m-lego/m65/README.md

the lego keyboard
=================

more info and notes [here](https://mlego.elena.re/m65/) and [here](https://mlego.elena.re/)
