m-lego/m65/notes/tipro8x4.md

## tipro 8x4

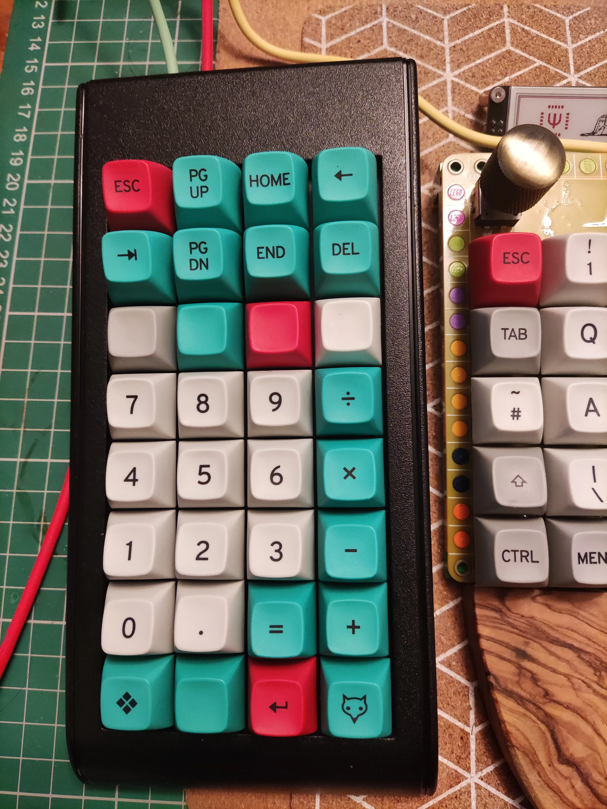
[picture p165: notes/pics/tipro/tipro8x4.webp]
tipro 32 8x4
  

### introduction

### wiring

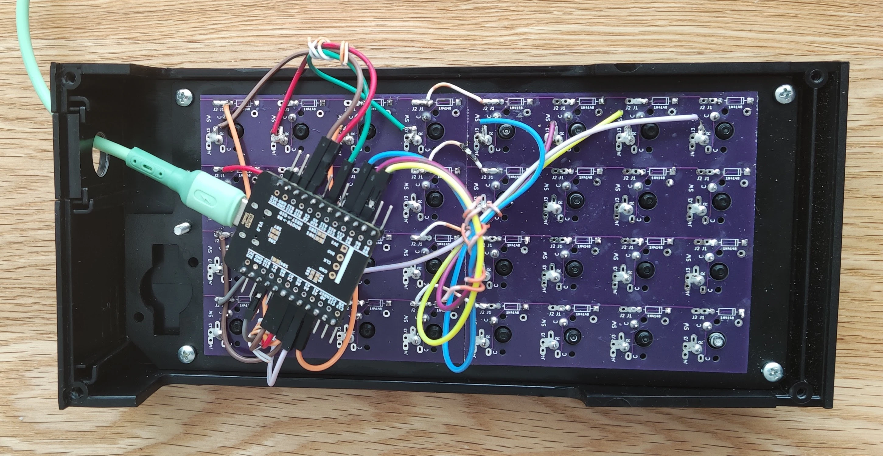
[picture p166: notes/pics/tipro/tipro8x4-pcb.webp]
tipro 32 8x16
 

### mcu

the mcu is stm32g431 from [weact](https://www.aliexpress.com/item/1005005303669884.html)

### firmware

  ready made firmware can be downloaded from [github actiona](https://github.com/alinelena/qmk_firmware/actions/workflows/build.yml)
naaviate to **build firmware for mlego** and click onthe latest successful workflow and download **tipro32_default** from the list.

### pictures

original

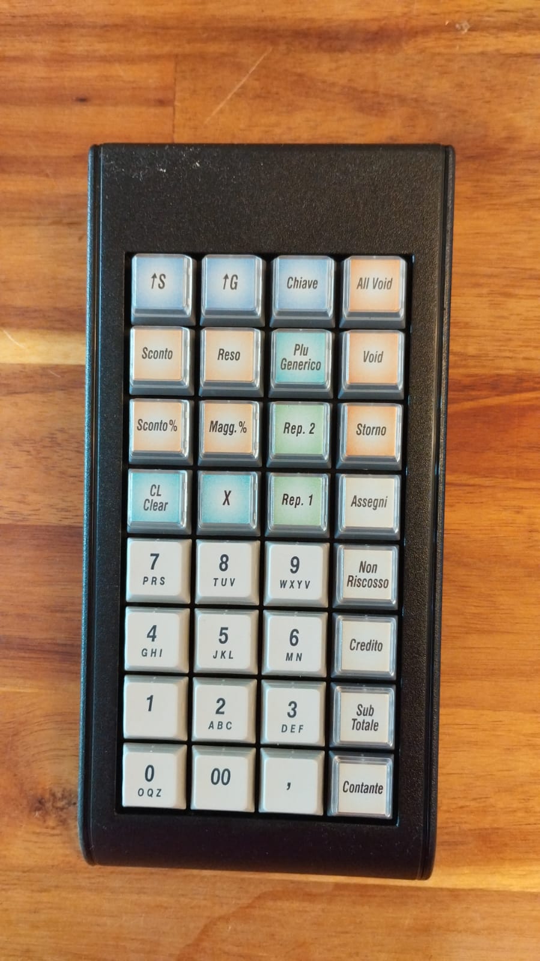
[picture p167: notes/pics/tipro/tipro8x4-orig.jpeg]
tipro 32 8x16
