m-lego/m65/notes/tiproansi-ortho.md

## tipro ansi ortho

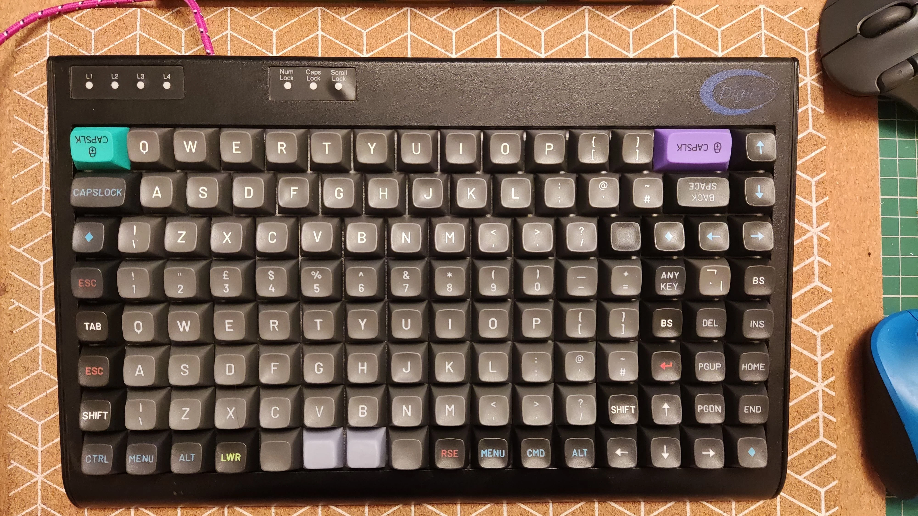
[picture p168: notes/pics/tipro/tiproansi-ortho.webp]
tipro 128 8x16
  

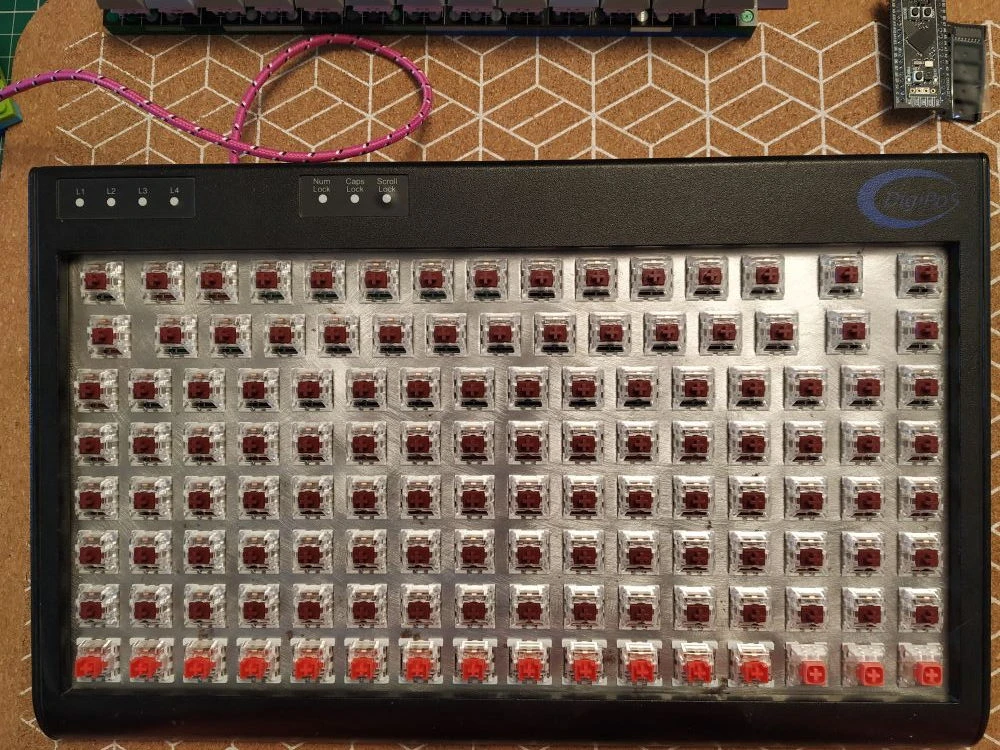
[picture p169: notes/pics/tipro/tipro-ansiortho-nokeys.webp]
tipro 128 8x16
  

### introduction

this is an ansi ortho combination from tipro that I have converted to qmk using same technique as [here](https://mlego.elena.space/tipro8x16/)

uses the same mcu.

### wiring

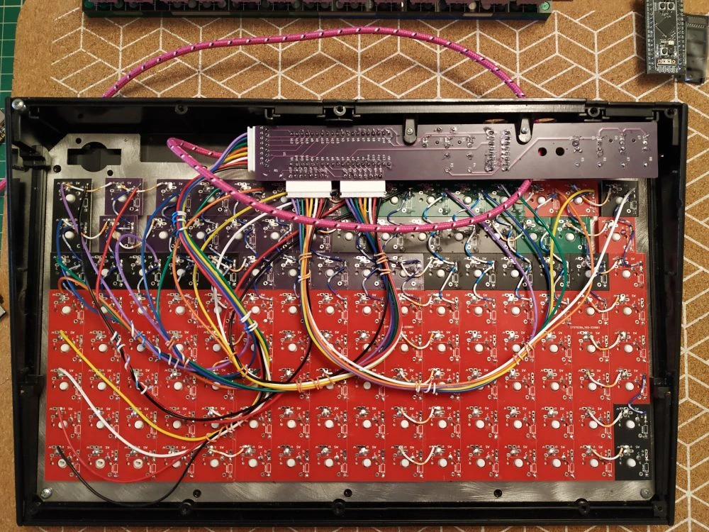
[picture p170: notes/pics/tipro/tiproansi-ortho-back.webp]
tipro 128 8x16
 

  full kicad project for the pcb in [here](https://gitlab.com/m-lego/hand8x16/)

### firmware

  ready made firmware can be downloaded

  + [tipro_rev1_default_ansiortho.uf2](https://gitlab.com/m-lego/hand8x16/-/blob/develop/firmware/tipro_rev1_default_ansiortho.uf2)

  build your own

   ```bash
      git clone --recurse-submodules -b mlego https://github.com/alinelena/qmk_firmware.git qmk-alin
      cd qmk-alin
      qmk compile -kb tipro/rev1 -km default_ansiortho

   ```

### pins

the same as 8x16

### photos

original

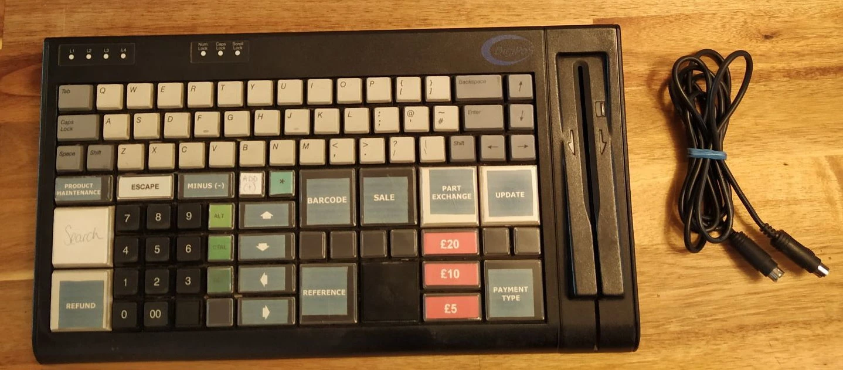
[picture p171: notes/pics/tipro/tipro-ansi-ortho-orig.webp]
tipro 128 8x16
