m-lego/m65/notes/tiproortho-ansi.md

## tipro ortho ansi

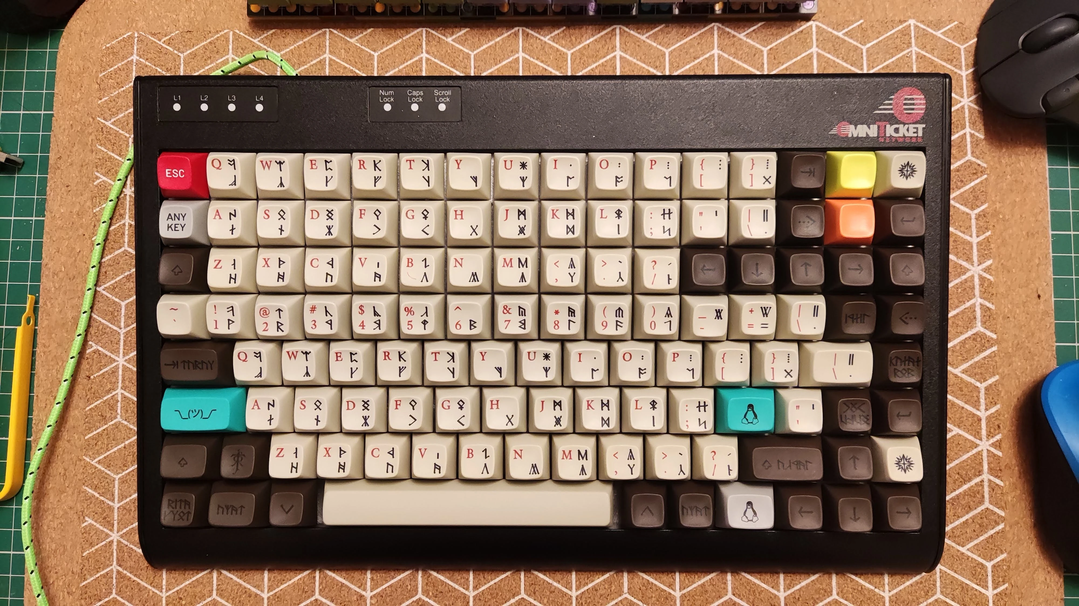
[picture p172: notes/pics/tipro/tiproortho-ansi.webp]
tipro 128 8x16
  

### introduction

this is an ortho ansi combination from tipro that I have converted to use qmk using same pcb as [here](https://mlego.elena.space/tipro8x16/)

this is in working, page updated once finished.

### wiring

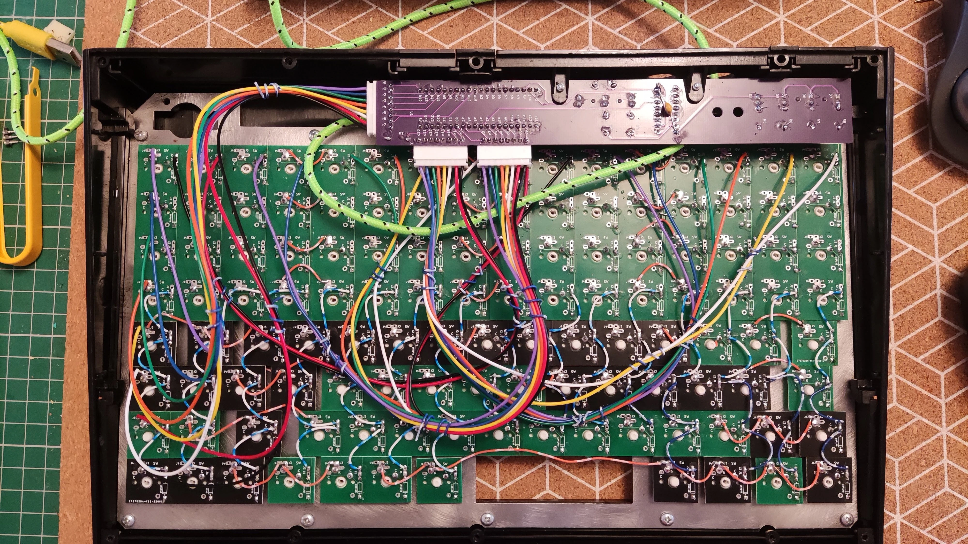
[picture p173: notes/pics/tipro/tipro_orthoansi_bottom.webp]
m128 ortho ansi


### firmware

### other pictures

original

m128 ortho ansi

cleaned

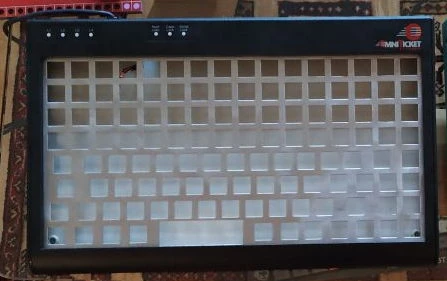
[picture p174: notes/pics/tipro/tipro-ortho-ansi-v1.webp]
m128 ortho ansi


switches

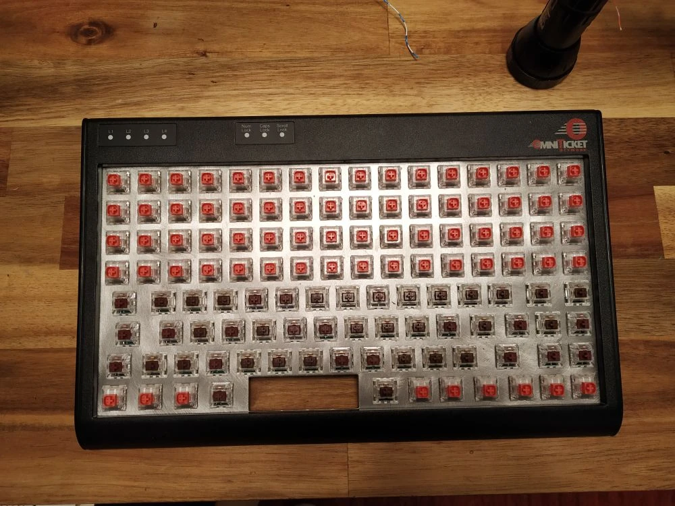
[picture p175: notes/pics/tipro/tipro-ortho-ansi-v2.webp]
m120 ortho ansi
