m-lego/m65/notes/converted/index.md

# converted

a set of converted pos terminals. All these are tipro they are mechanical so I just adapted them.
Majority came from ebay relatively cheap.

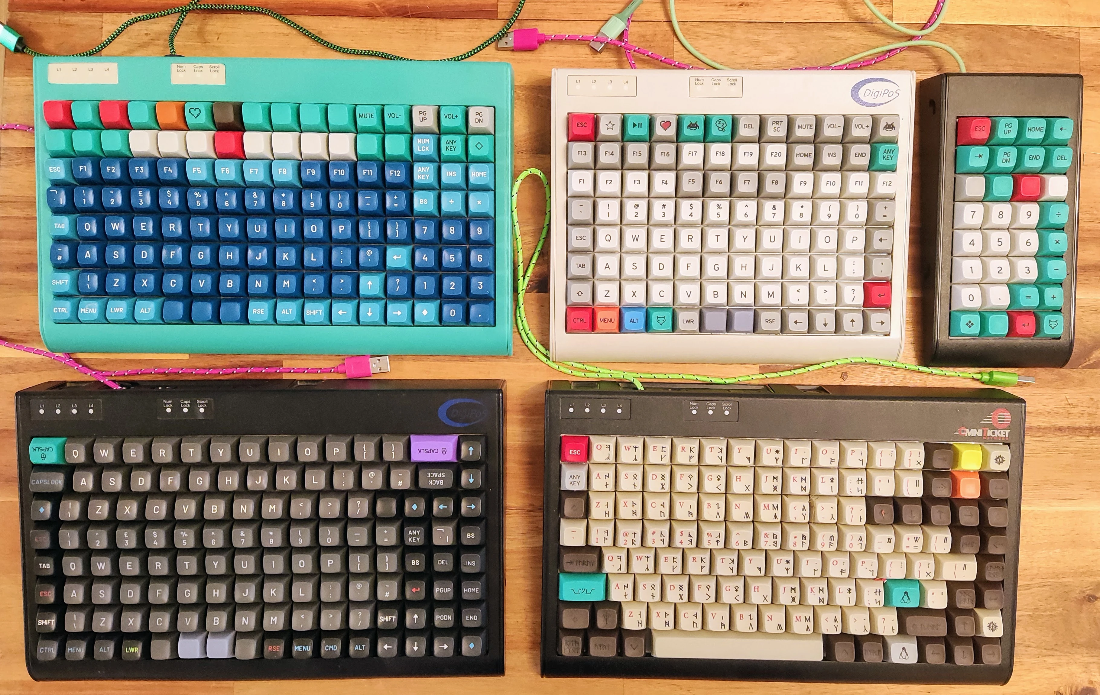
[picture p180: notes/pics/converted-all.webp]
converted pos
