m-lego/m65/notes/keyboards/index.md

# Keyboards

a set of keyboard that I have designed and built for fun and to eperiment with qmk or electronics.

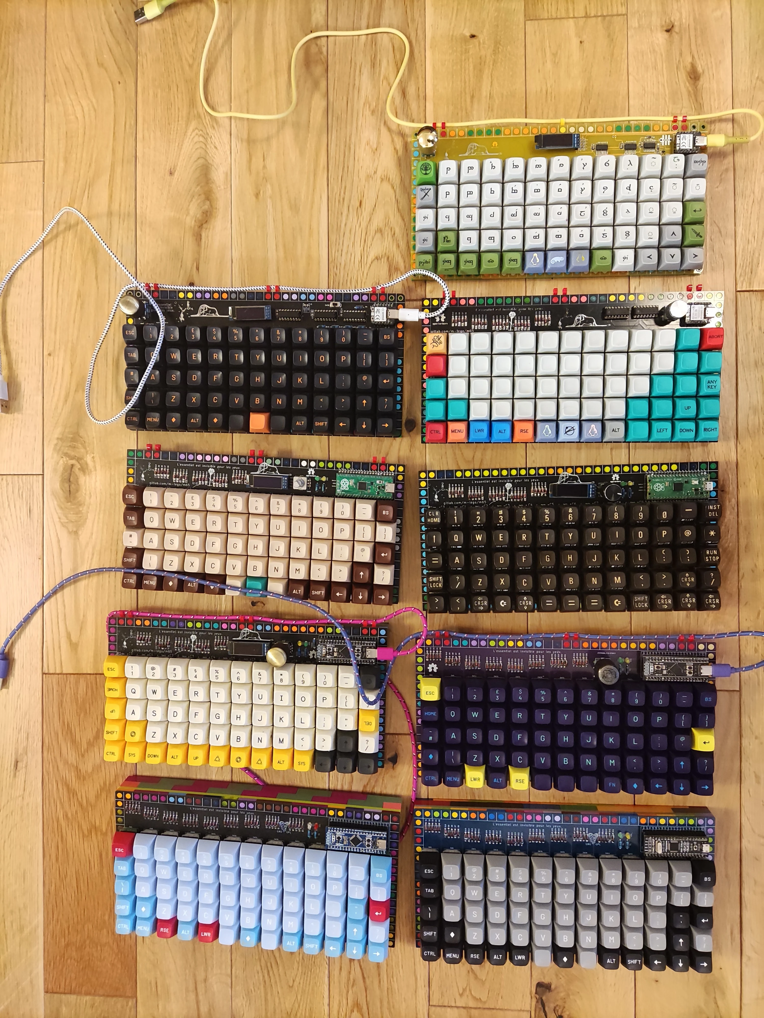
[picture p181: notes/pics/m65-rev1-10.webp]
the family
