m-lego/m65/notes/pics/hand/hand-5x5-3d.webp

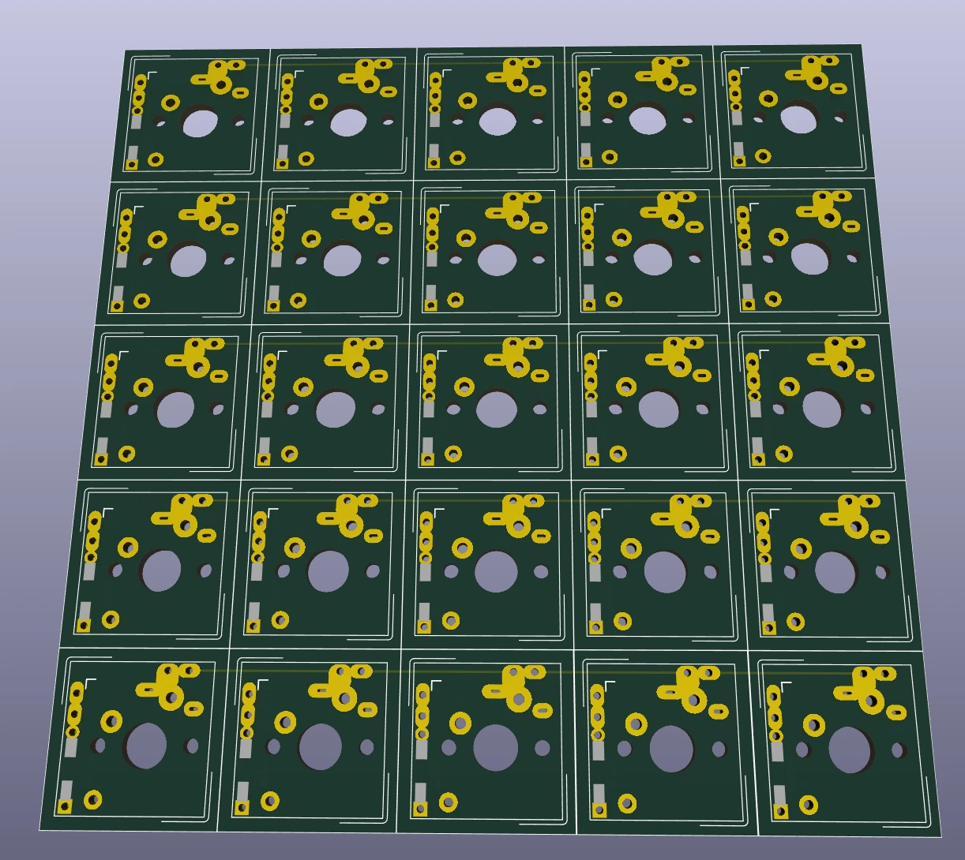
notes/pics/hand/hand-5x5-3d.webp
