m-lego/m65/notes/pics/hand/m4-matrix-pcb.webp

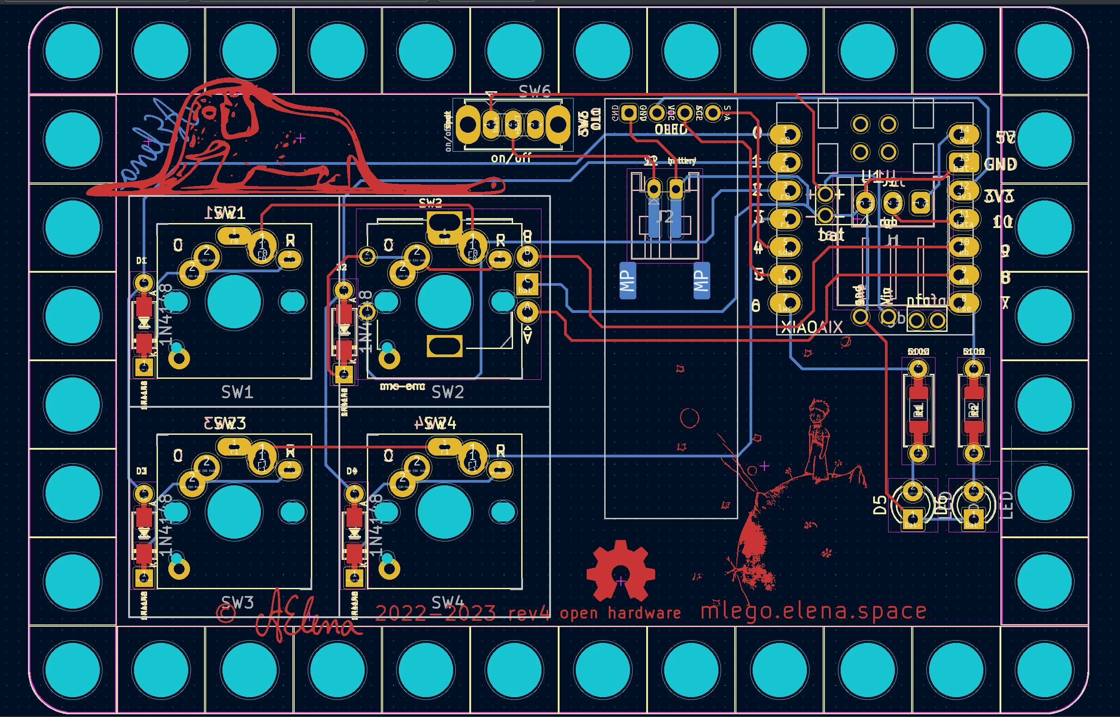
notes/pics/hand/m4-matrix-pcb.webp
