m-lego/m65/notes/pics/m4/m2x2-rev4-3d.webp

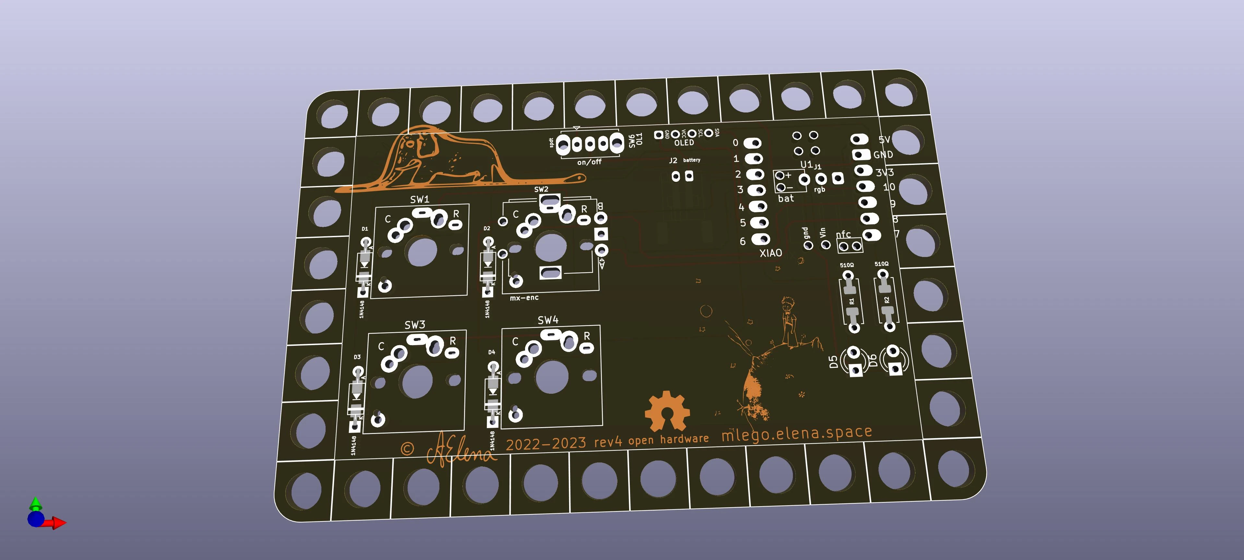
notes/pics/m4/m2x2-rev4-3d.webp
