m-lego/m65/notes/pics/m20/m20_v3.webp

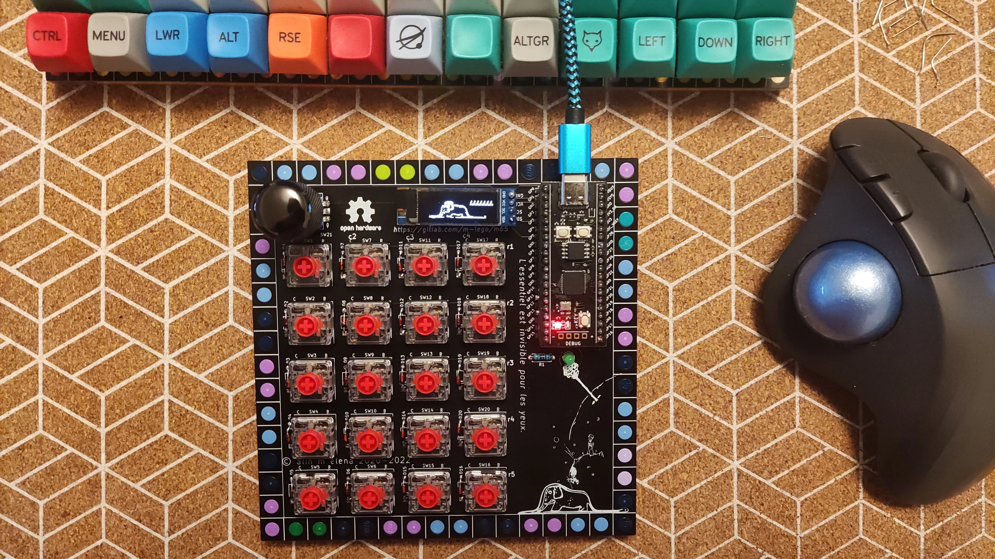
notes/pics/m20/m20_v3.webp
