m-lego/m65/notes/pics/m65-rev7-xiao-ble.webp

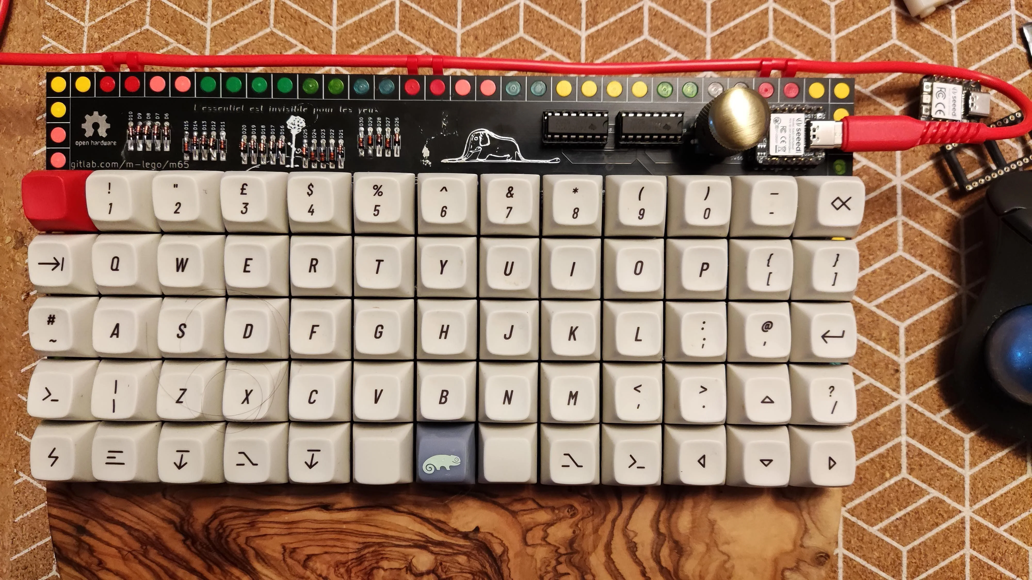
notes/pics/m65-rev7-xiao-ble.webp
