m-lego/m65/notes/pics/m65-rev9-render.webp

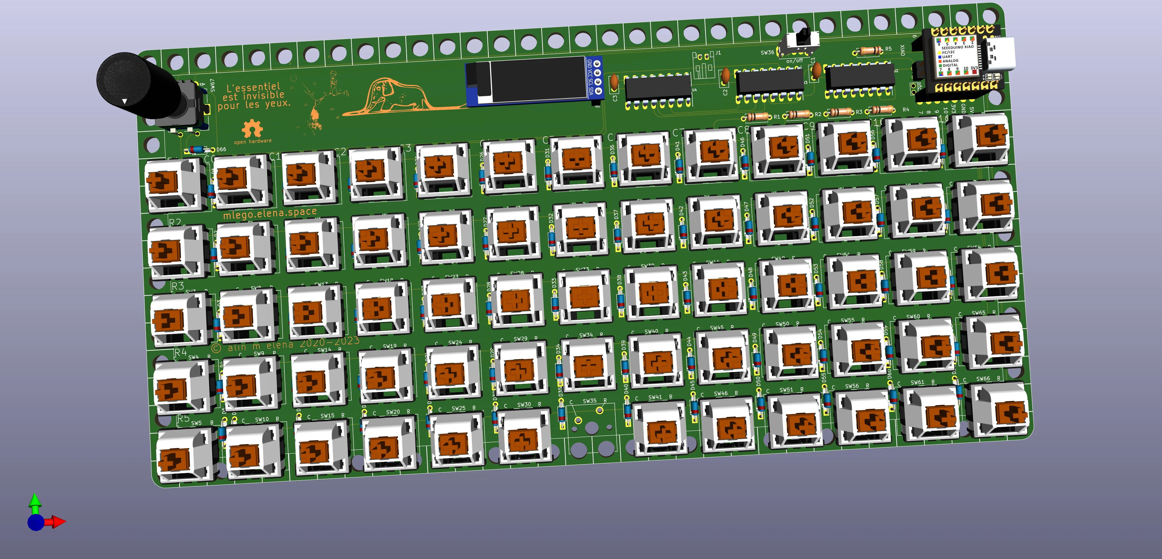
notes/pics/m65-rev9-render.webp
