m-lego/m65/notes/pics/mlego.webp

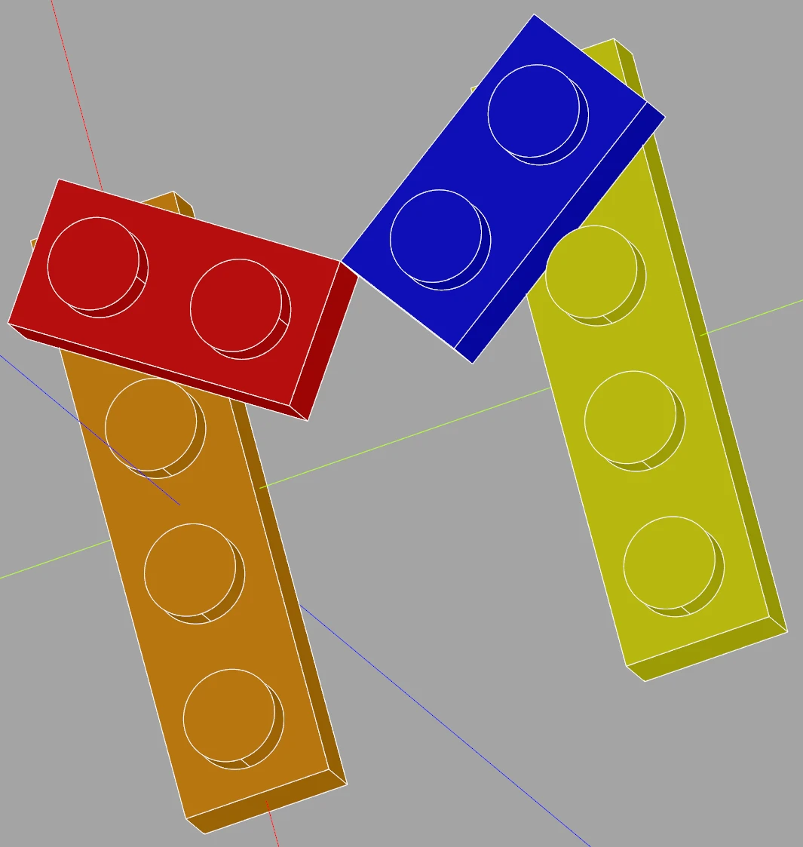
notes/pics/mlego.webp
