m-lego/m65/pics/m65-layout.png

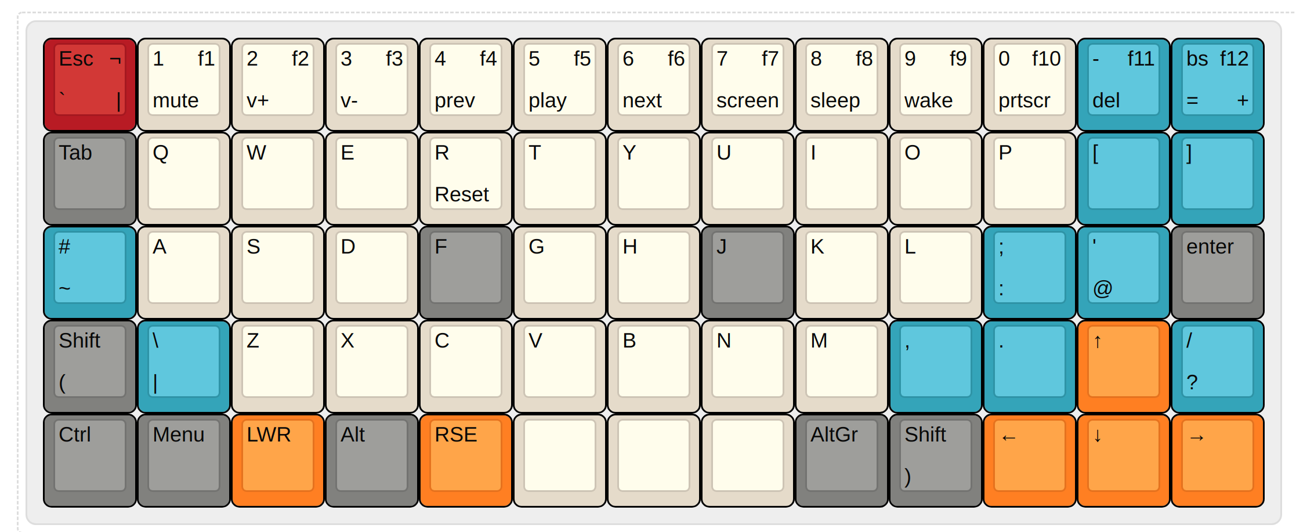
pics/m65-layout.png
