m-lego/m65/pics/m65-rev4-pcb.png

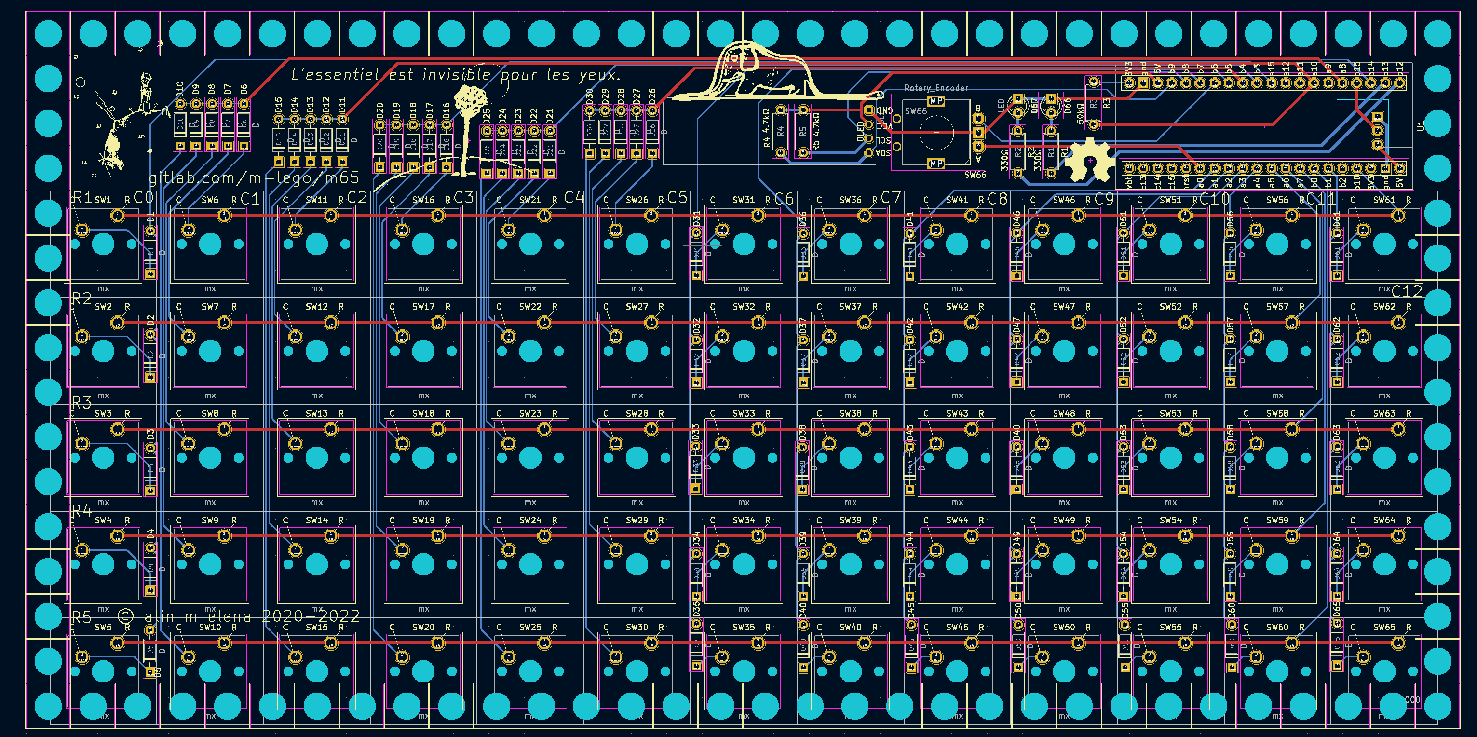
pics/m65-rev4-pcb.png
