m-lego/m65/pics/m65-rev4.jpg

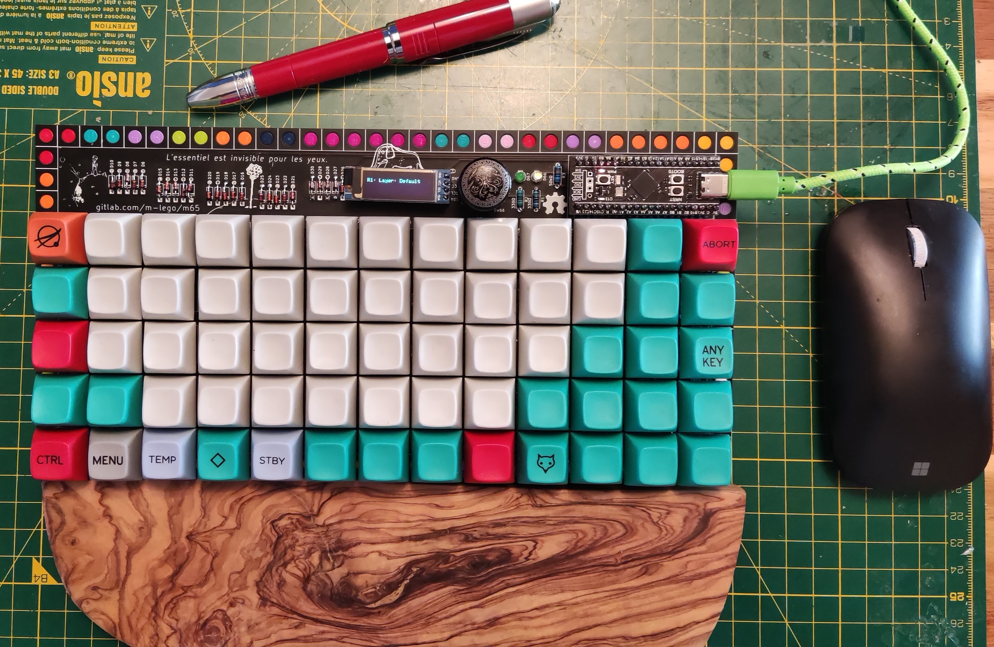
pics/m65-rev4.jpg
