m-lego/m65/pics/m65-tty.png

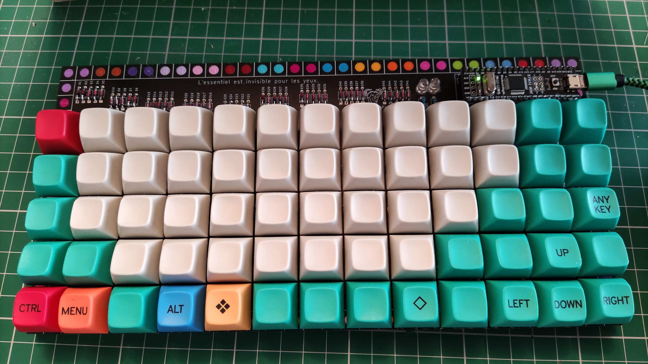
pics/m65-tty.png
