m-lego/m65/pics/m65-v4.jpg

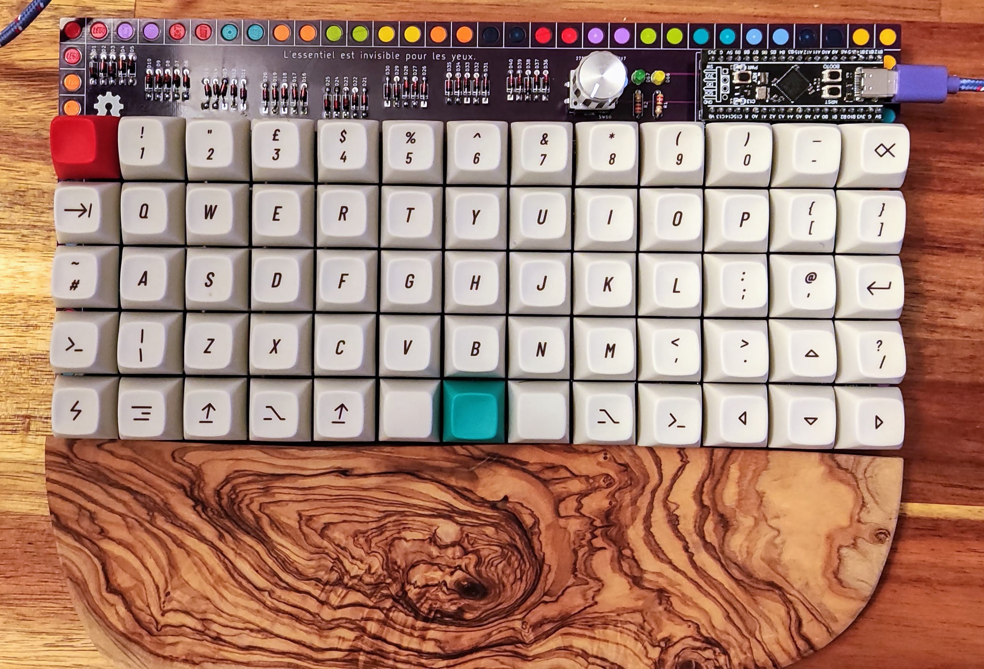
pics/m65-v4.jpg
