m-lego/m65/pics/socket_4.jpg

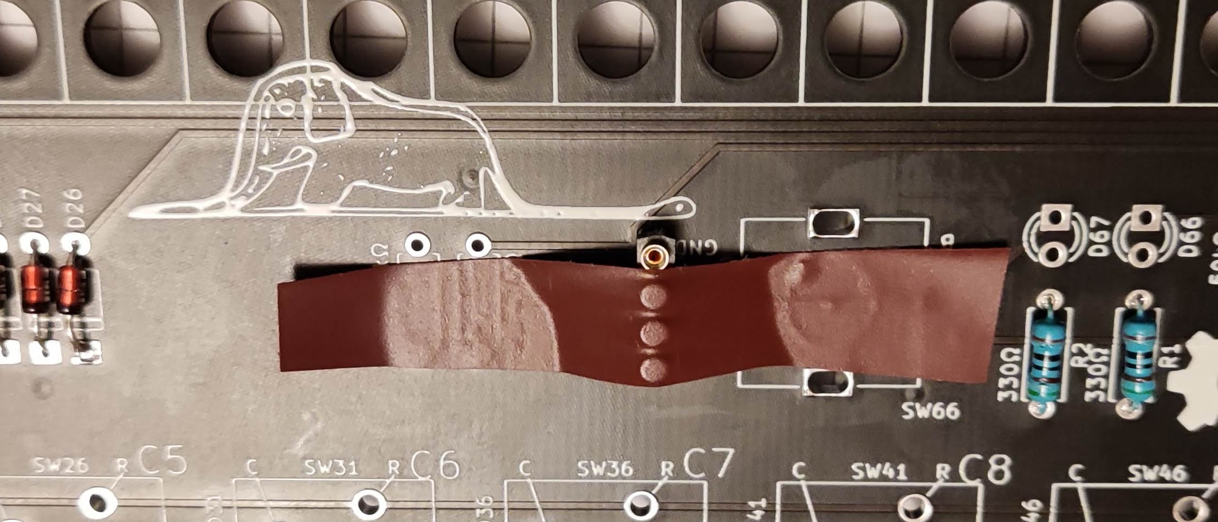
pics/socket_4.jpg
