m-lego/m65/notes/assembly.md

## assembly guide

### before you start

!!! warning

    this is a rushed assembly guide... assumes you know how to solder and you already read the bom section and have all of them plus the pcb.
    while the complexity of the job is low, it may take over 2h of your time to put it together.

!!! info

    familiarise yourself with the pcb

front of the pcb

pcb

back of the pcb

pcb

front of the PCB is the one with the artwork on.
you can ignore R4 and R5 since they are for use only in advaced cases when special oleds are used.
if you go for the full build all other footprints will be populated.

### mcu

!!! tip

    whatever mcu you are using I suggest strongly to socket it.

first step is to add headers on it.

i use round pins and dil sockets, 40 way. picture below

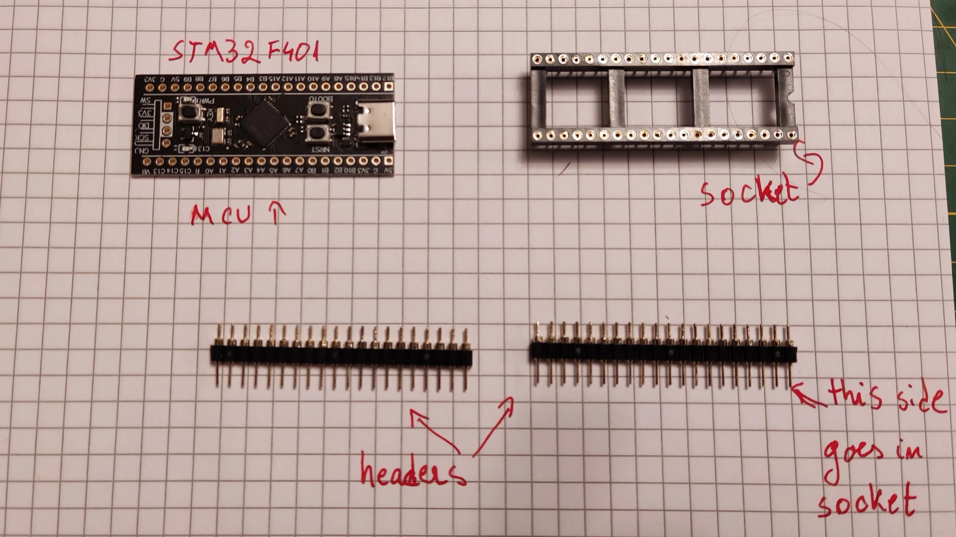
[picture p196: notes/pics/header_1.webp]
header mcu


you can also use single row female headers, recommended if you use boards like raspberry pi.

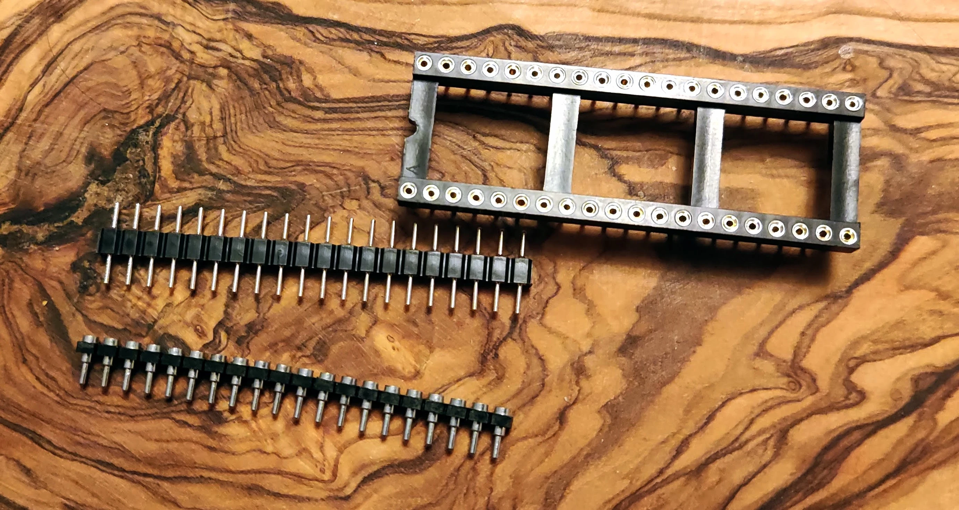
[picture p197: notes/pics/sockets.webp]
header mcu alternatives


!!! danger

    put the headers into the socket no need to fully insert them just be sure the conical bit points towars the socket and the mcu on
    top. see picture below.

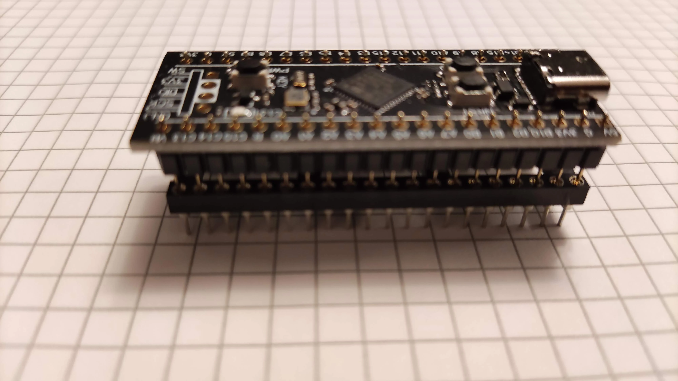
[picture p198: notes/pics/header_2.webp]
header mcu


!!! info

    be sure headers are vertical and stable. now you can start soldering.

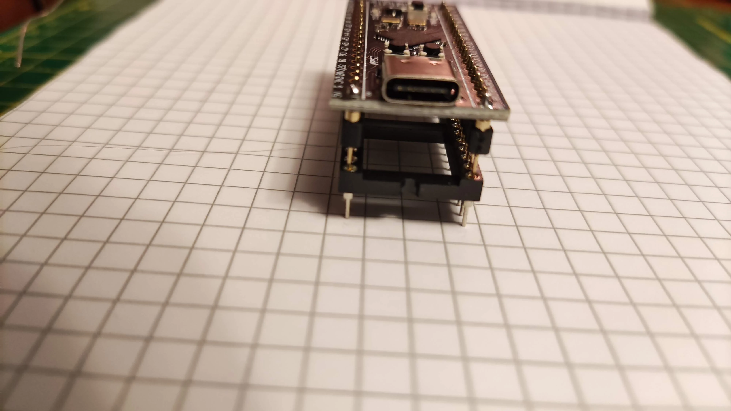
[picture p199: notes/pics/header_3.webp]
header mcu


I solder usually the extremes for each row and then the rest.

finally shall look like this

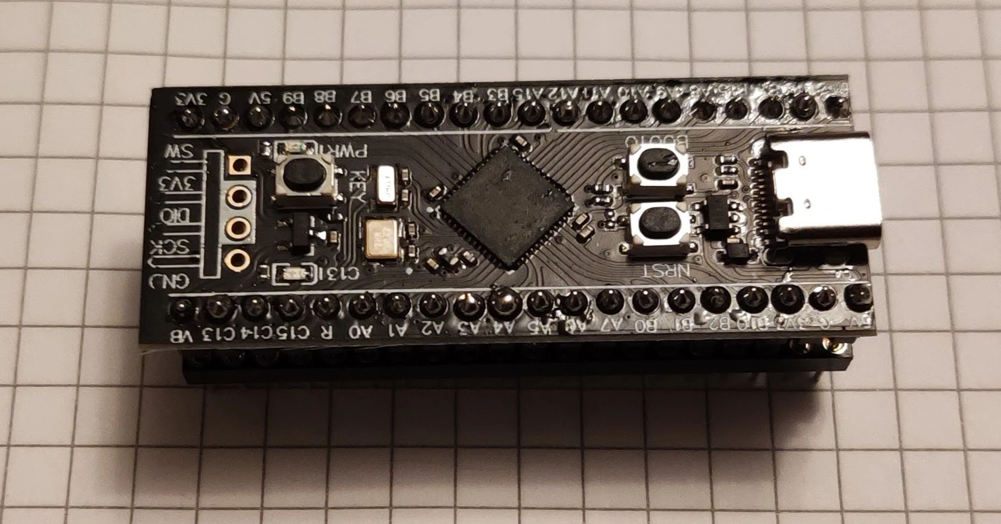
[picture p200: notes/pics/header_4.webp]
header mcu


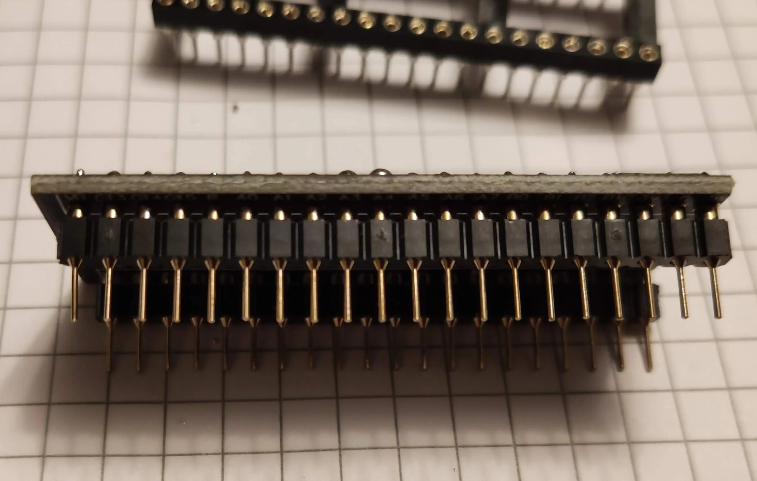
[picture p201: notes/pics/header_5.webp]
header mcu


### oled

if you are using an oled i suggest to socket it too. Again I use round pins 4 in a row are enough and use a low profile socket, see
below.

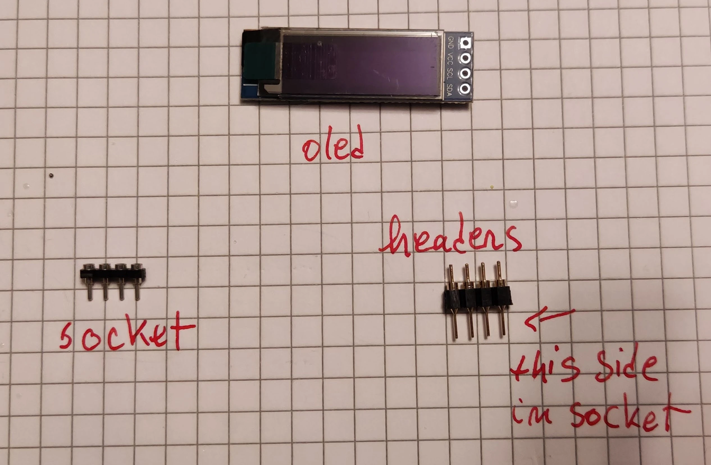
[picture p202: notes/pics/header_6.webp]
header oled


for soldering this you can use the pcb as support. add the headers into the pcb(conical side towards pcb) put the oled on top and be
sure is vertical. you can use some blue tack or tape(electrical, painters, etc).

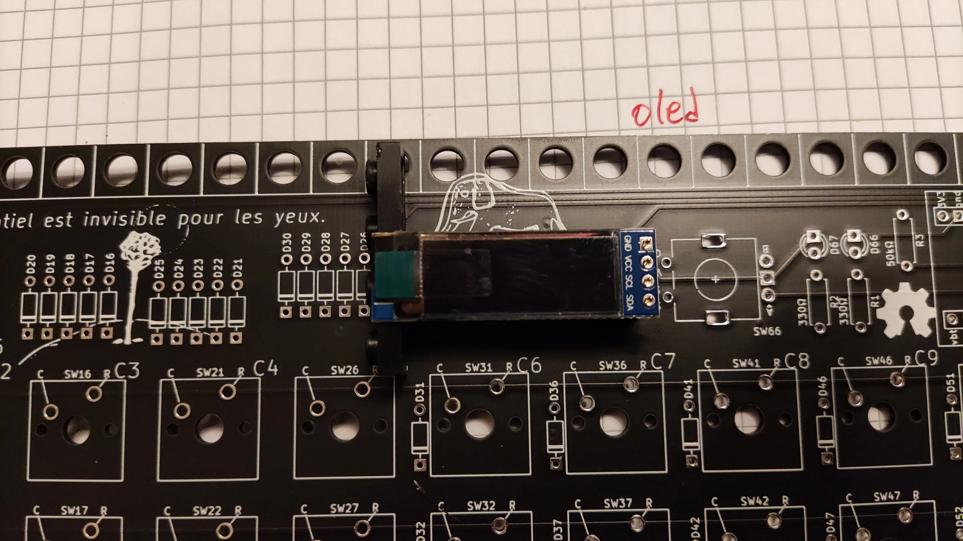
[picture p203: notes/pics/header_7.webp]
header oled


now you can solder the oled(be sure you do not solder the keyboard pcb
side). Once done you can remove it from pcb shall look like this.

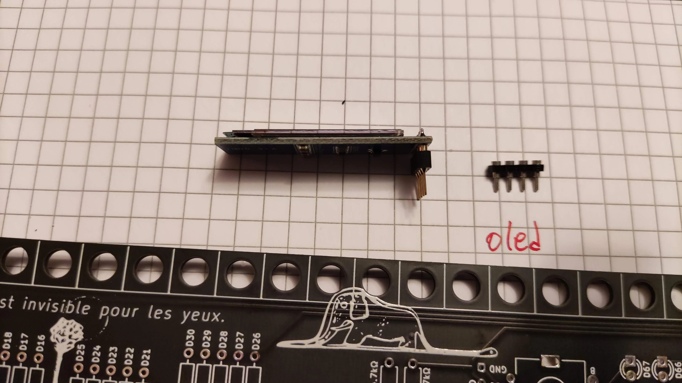
[picture p204: notes/pics/header_8.webp]
header oled


### diodes

get 65 of them 1n4148 do-35, they look like this.

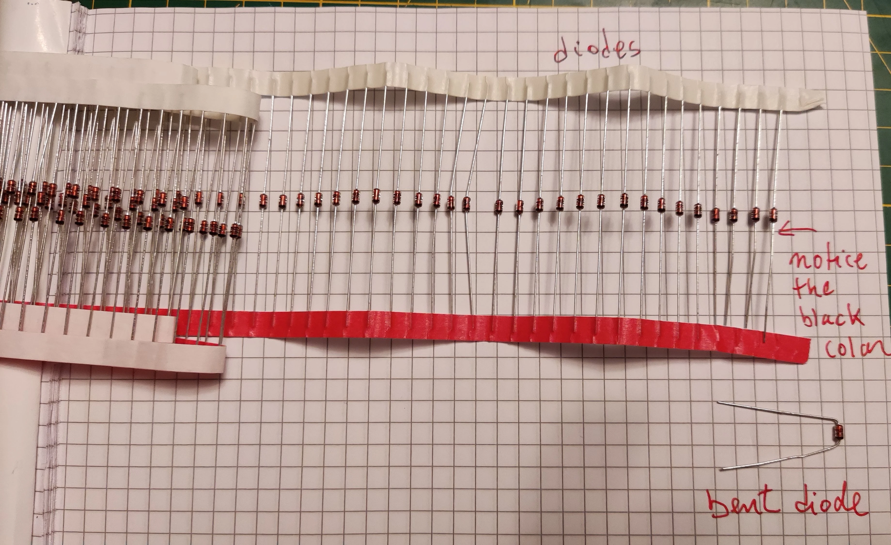
[picture p205: notes/pics/diodes_1.webp]
diodes


!!! danger

    note the black ring/colar at one end.

bend the legs at 90˚ like in the picture above.

!!! danger

    insert them in the holes, with the black colar oriented to the lower part of the board.
    see picture.

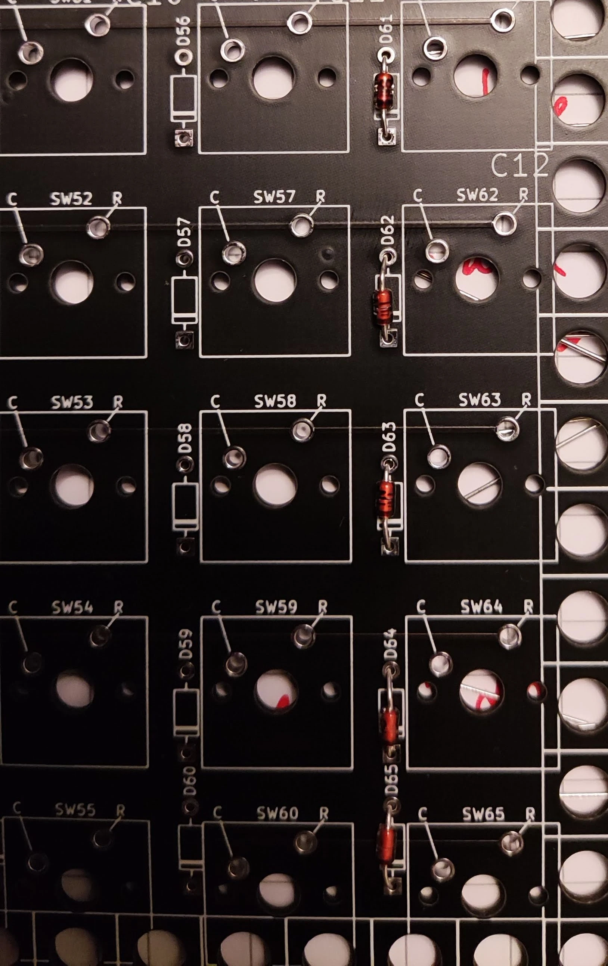
[picture p206: notes/pics/diodes_2.webp]
diodes


bend the legs on the reverse of the pcb to assure the diode is fixed in the position. bending in the opposite direction helps for
better stability during soldering.
see picture.

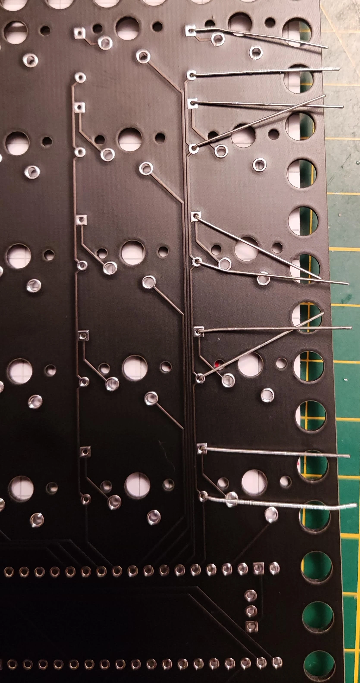
[picture p207: notes/pics/diodes_3.webp]
diodes


!!! danger

    now you can solder, once done, wriggle the legs of the diode until they detach, leaving a clean cut at solder level. you may want to
    reflow the joint after you remove the leg. wiggling may cause damage to the joint. alternatively use a flush cutter if you have
    one makes things faster.

see picture

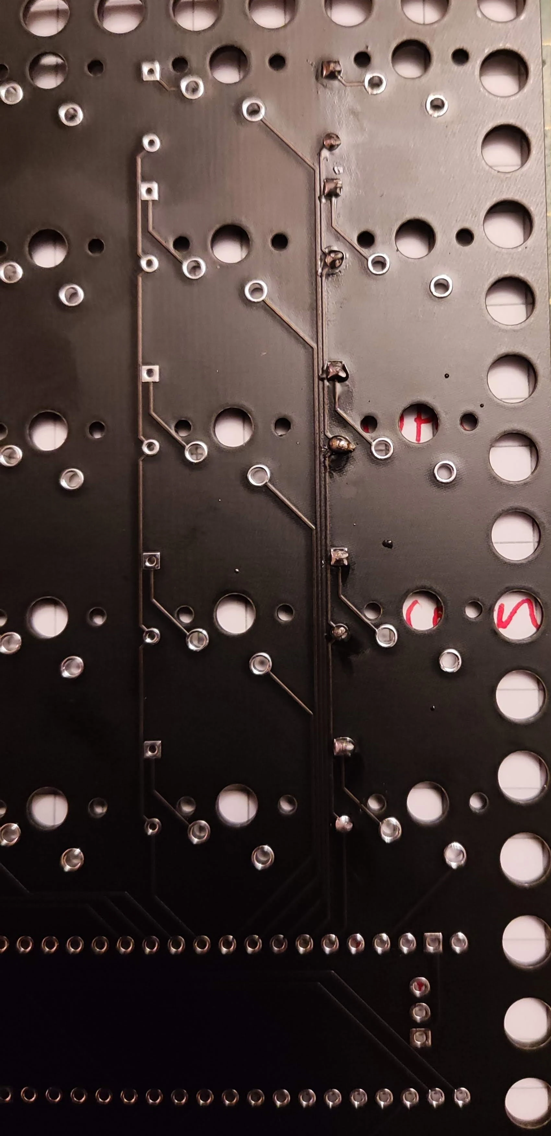
[picture p208: notes/pics/diodes_4.webp]
diodes


repeat for all the diodes next to the switches. you may find it easier if you work your way for each column.

for the diodes at the top, bending shall be done differently, see picture. this allows to add them all in one go.

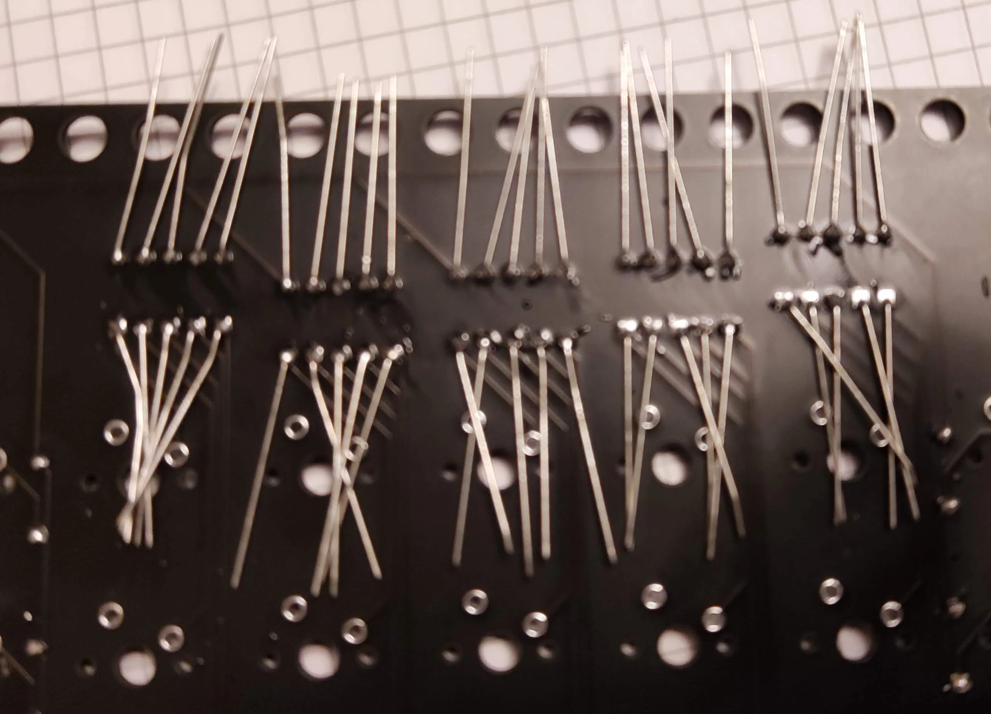
[picture p209: notes/pics/diodes_5.webp]
diodes


finally once you are over shall look like this or better

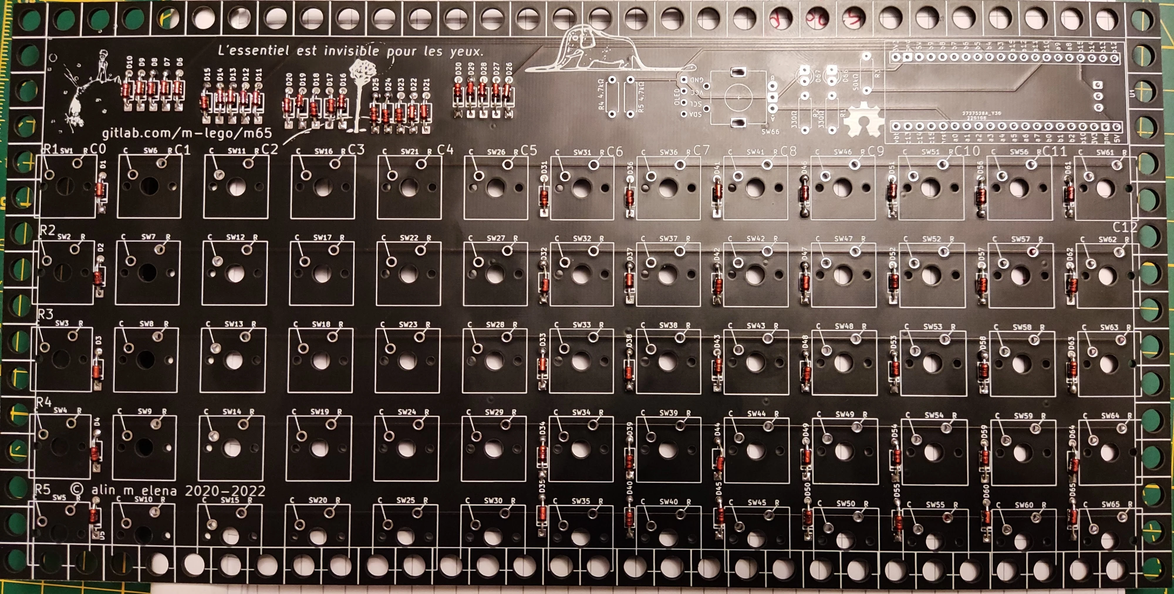
[picture p210: notes/pics/diodes_6.webp]
diodes


### resistors

there are max three resistors you need to put procedure is the same as for the diodes, bend, insert, bend.
it does not matter how you insert them, just be sure you have the right values in the right places.

!!! warning

    R3  is 100kΩ(you can use 22kΩ). this is needed for blackpill to enter reliably in boot mode

!!! warning

    R1 and R2 need to be calculated based on the colour of the led used and desired intensity. for yellow and green leds I
    use 510Ω(not very bright) and for white leds 1kΩ (quite bright)

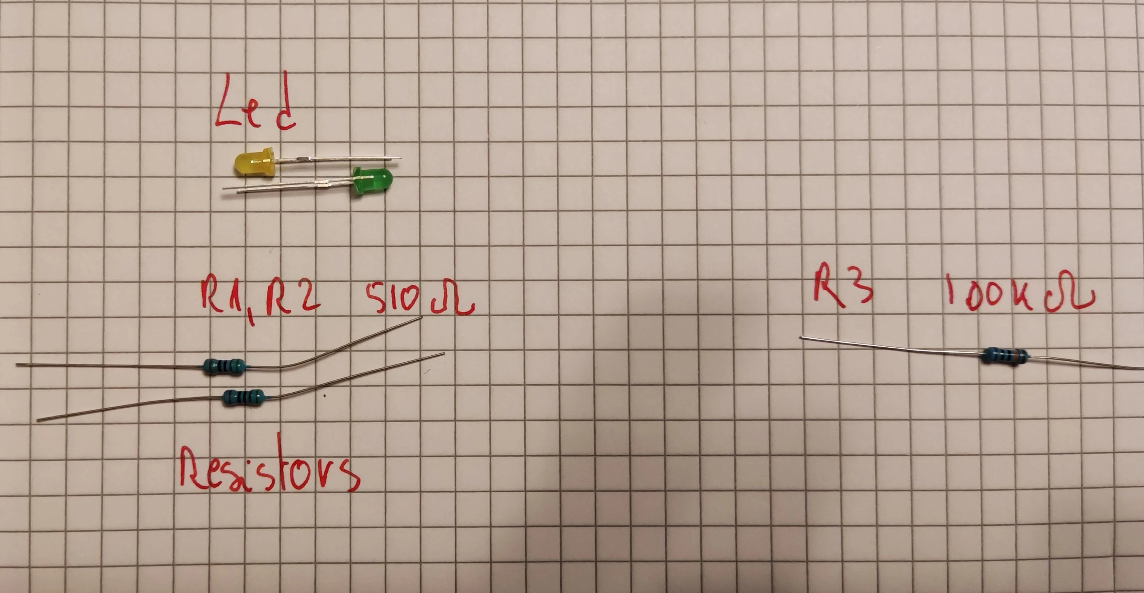
[picture p211: notes/pics/resistor_1.webp]


!!! note

    you may want to use a breadboard to test before to see if you are happy with the intensities, use a 3.3V DC source. alternatively
    you can use the mcu itself. if you do not have a breadboard dupont wires may be enough.
    also in this step you will determine the led orientation... note which leg goes to 3.3V and which one goes to ground.
    this step is important since I noticed some of the leds do not follow the convention... long leg positive, short leg negative.

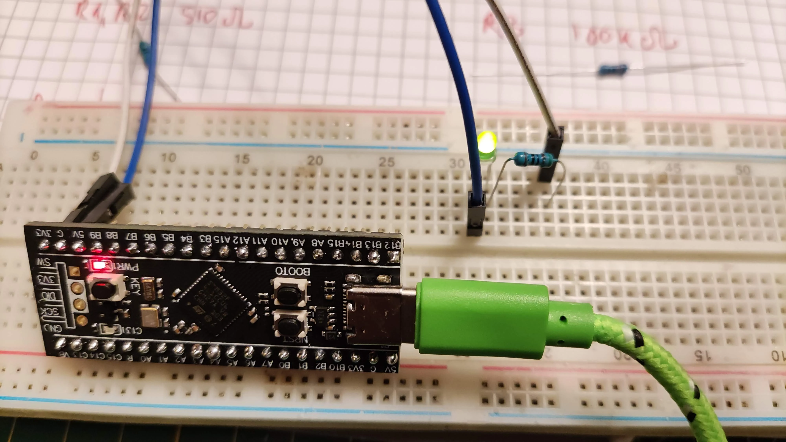
[picture p212: notes/pics/resistor_2.webp]


### sockets

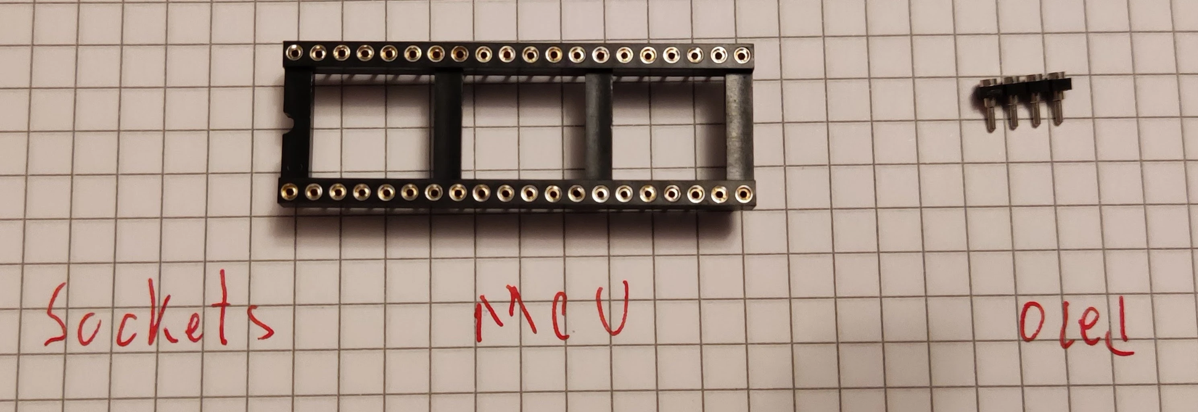
[picture p213: notes/pics/socket_1.webp]
socket mcu


put the 40 way dil socket into the pcb (front side). secure it with tape.

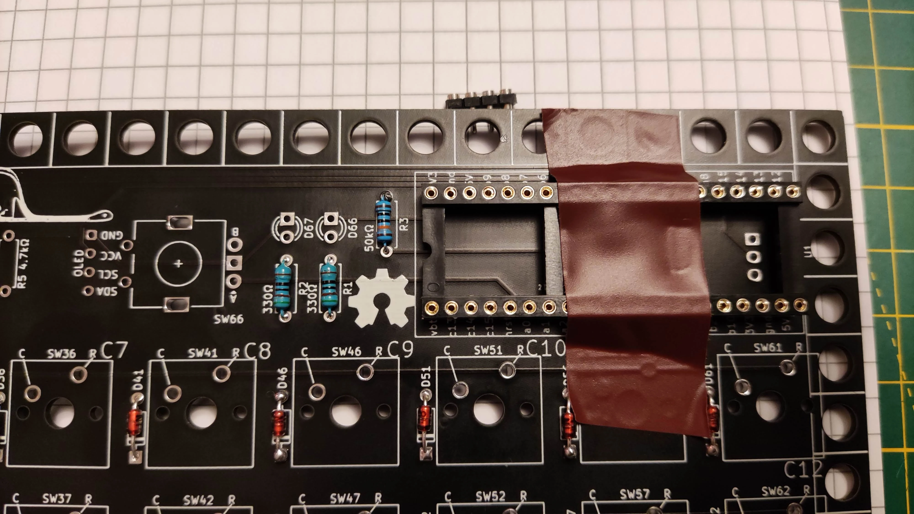
[picture p214: notes/pics/socket_2.webp]
socket oled


turn the pcb. you can solder the  extreme pins on rows. be sure the socket is properly aligned with the pcb

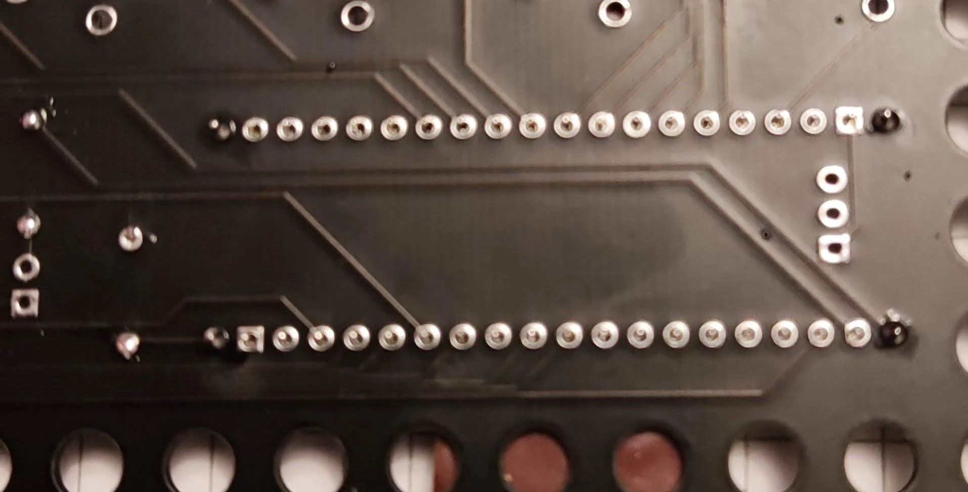
[picture p215: notes/pics/socket_3.webp]
socket oled


next repeat the same but with the oled socket.

### leds

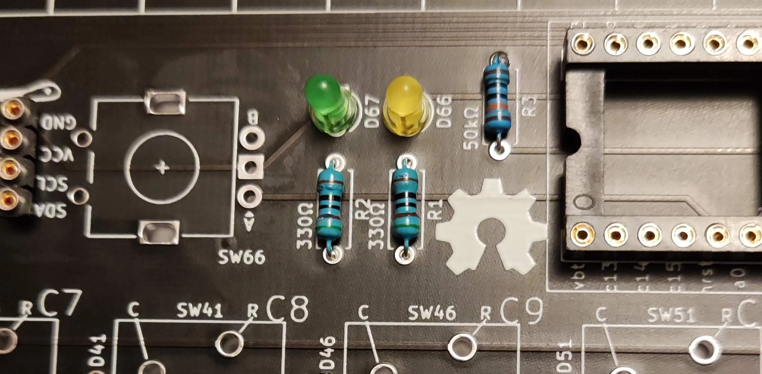
[picture p216: notes/pics/led_1.webp]


!!! danger

    put the leds in the right position, matching the resistor value determined before. also you need to be sure the leg that pointed to
    ground goes in the hole with the square plating. once inserted you can bend the legs on the back of the board and solder them.
    wriggle to remove the legs.

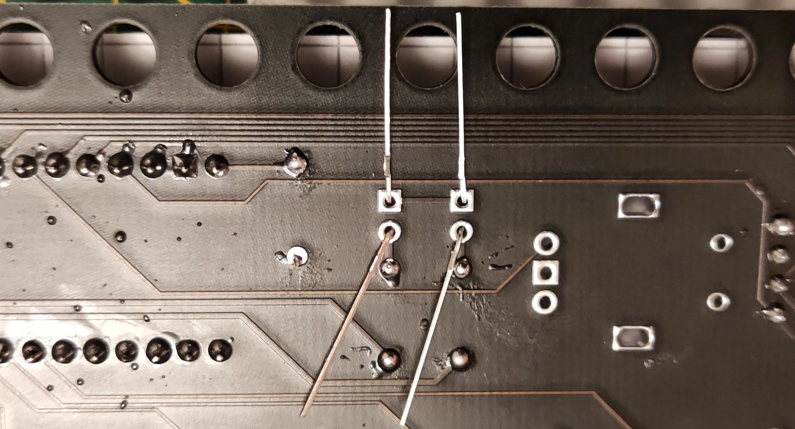
[picture p217: notes/pics/led_2.webp]


### switches

you need 65 switches 5 pins. be sure the legs are not bent. in general switches shall fit quite tight so you may have to push.
once they are in place inspect all of them are aligned. just look along columns and rows and see if any is out of place... if yes
just push them.

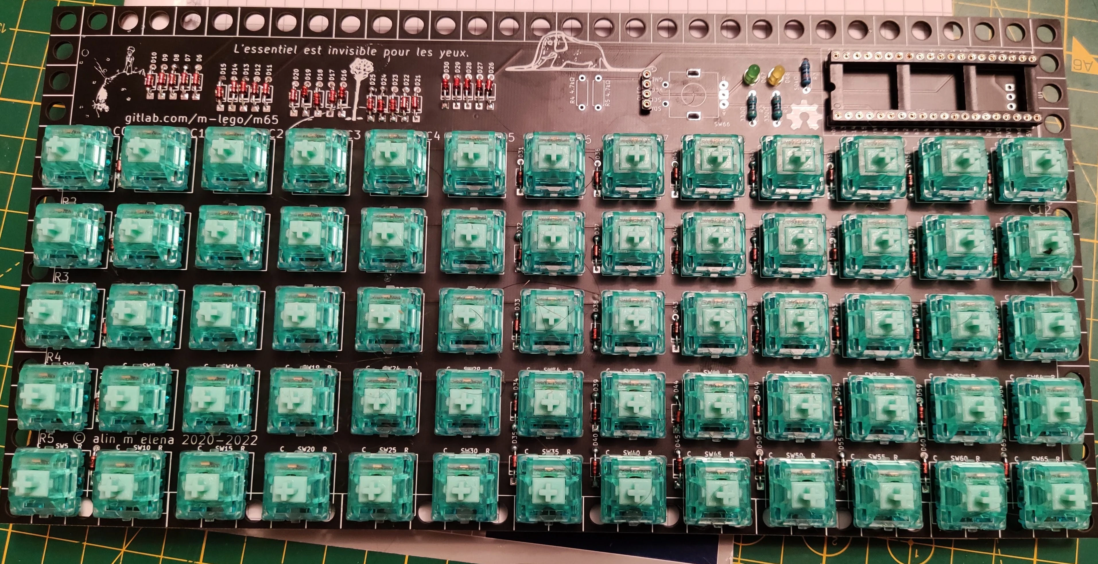
[picture p218: notes/pics/switches_1.webp]
switches front


!!! warning

    some switches do not fit tight (kailh for example) you will need to be creative and use a hardcover book or something to turn then
    on the over side to solder.

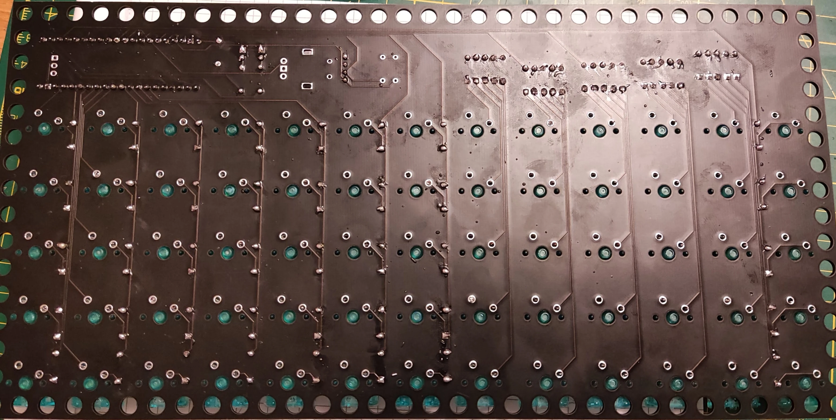
[picture p219: notes/pics/switches_2.webp]
switches front


now you can solder...

### encoder

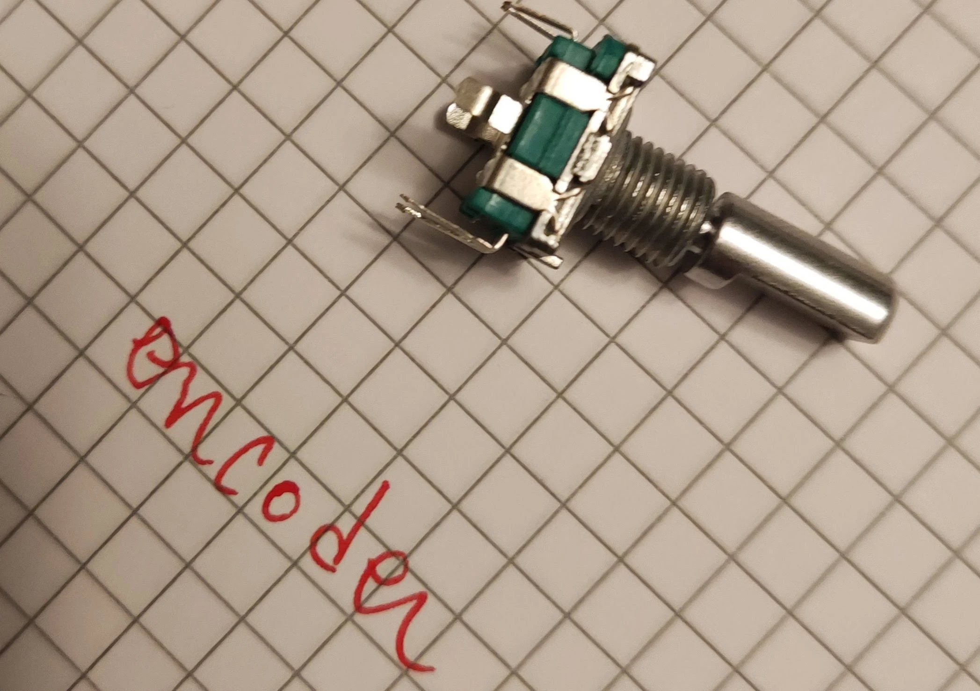
[picture p220: notes/pics/encoder_1.webp]
encoder front


carefully push the encoder in its place. there are 5 pin but only 3 are used (in some models rev9 and after all are used), solder all of them and also consider soldering the
oval ones too...

if all is ok now looks like this

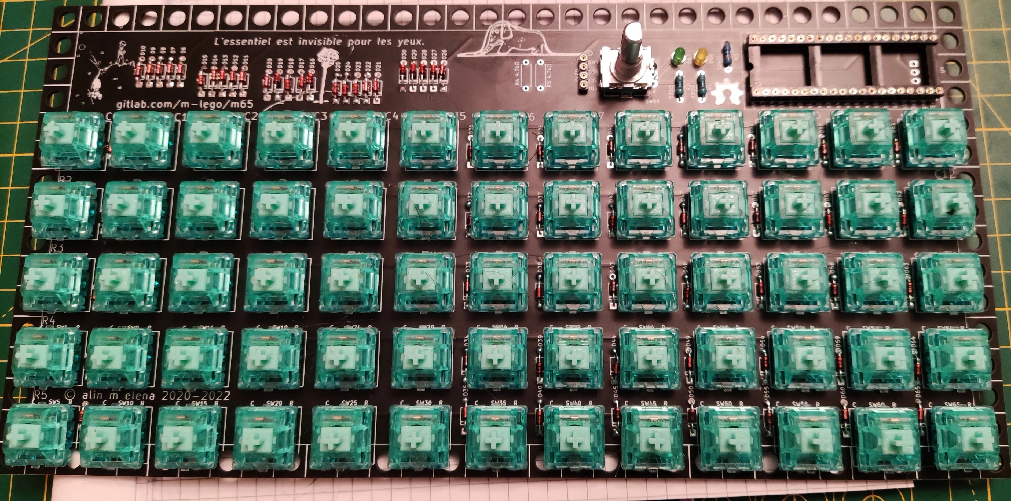
[picture p221: notes/pics/encoder_2.webp]
encoder front


!!! success

    at this point everything shall work..

### the box

lego

you can use a 16x32 plate or 2x16x16 plates and a mixture of lego plates, 1x2 and/or 1x4, corners if you have too.
Also you can use a full brick and plate to give it a typing angle (around 6˚) already assembled in the picture above.

put it as you please

lego

now you can put the pcb on top of the box base matching the lego inside. press gently till they are properly fit. thickness of the
pcb is same as the lego prongs so you shall see them flush.

!!! warning

    depending on the lego colours, plates sometimes you may notice a bend of the pcb. you will have to experiment with various
    colours for plates, nothing one cannot solve with lego.

now you can socket mcu, oled and the knob of the encoder and plug it in.

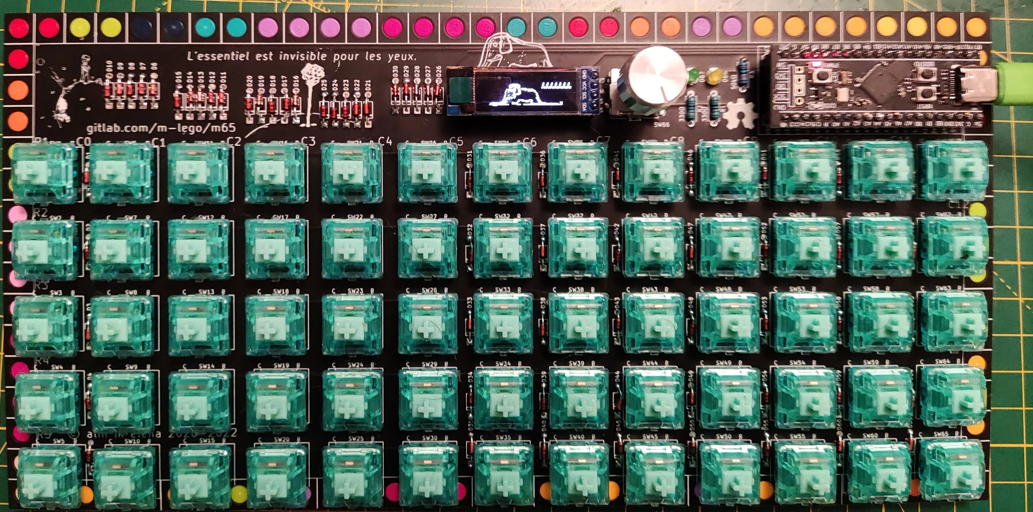
[picture p222: notes/pics/final_1.webp]


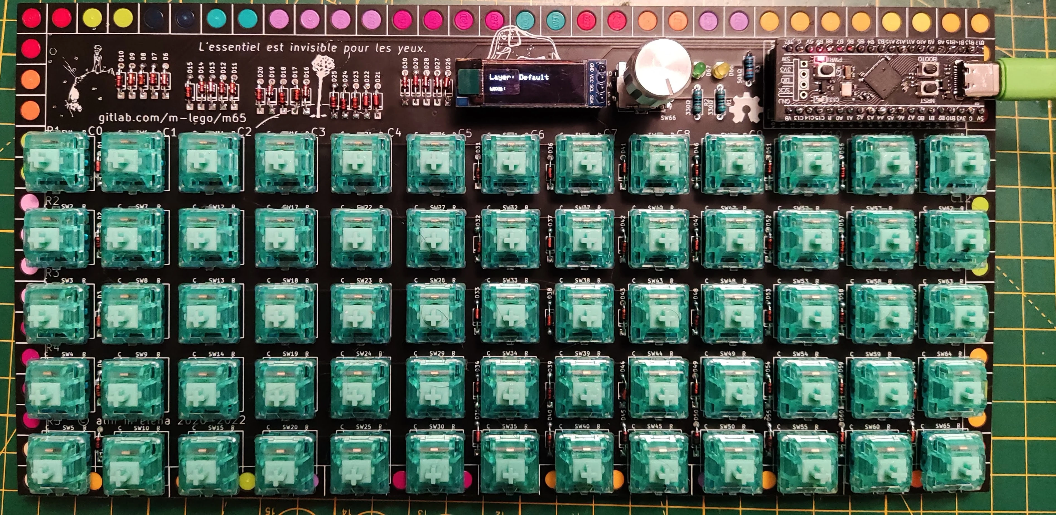
[picture p223: notes/pics/final_2.webp]


!!! success "testing time"

    + if screen lights up showing an elephant inside a python it is perfectly fine. after few seconds, shall indicate you the the current layer and show wpm(some estimate of words per minute)
    + encoder shall change the volume
    + double tap dance the third key from the left on the bottom row, first led from the encoder shall be on... do it again shall be off...
    + double tap dance the fifth key from the left on the bottom row, second led from the encoder shall be on... do it again shall be off...
    + now you are ready to test the keys...

if anything goes wrong you will need to debug... otherwise put the keycaps and enjoy.

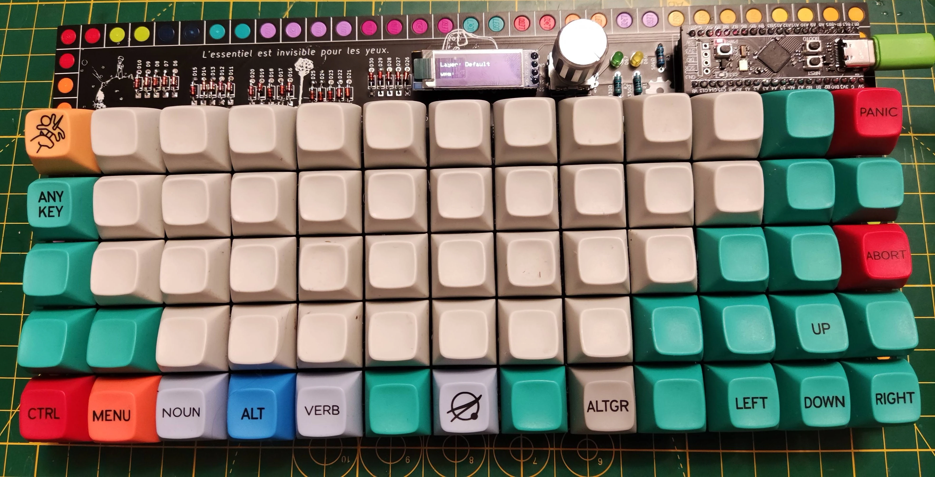
[picture p224: notes/pics/final_3.webp]
