m-lego/m65/pics/m65.pdf

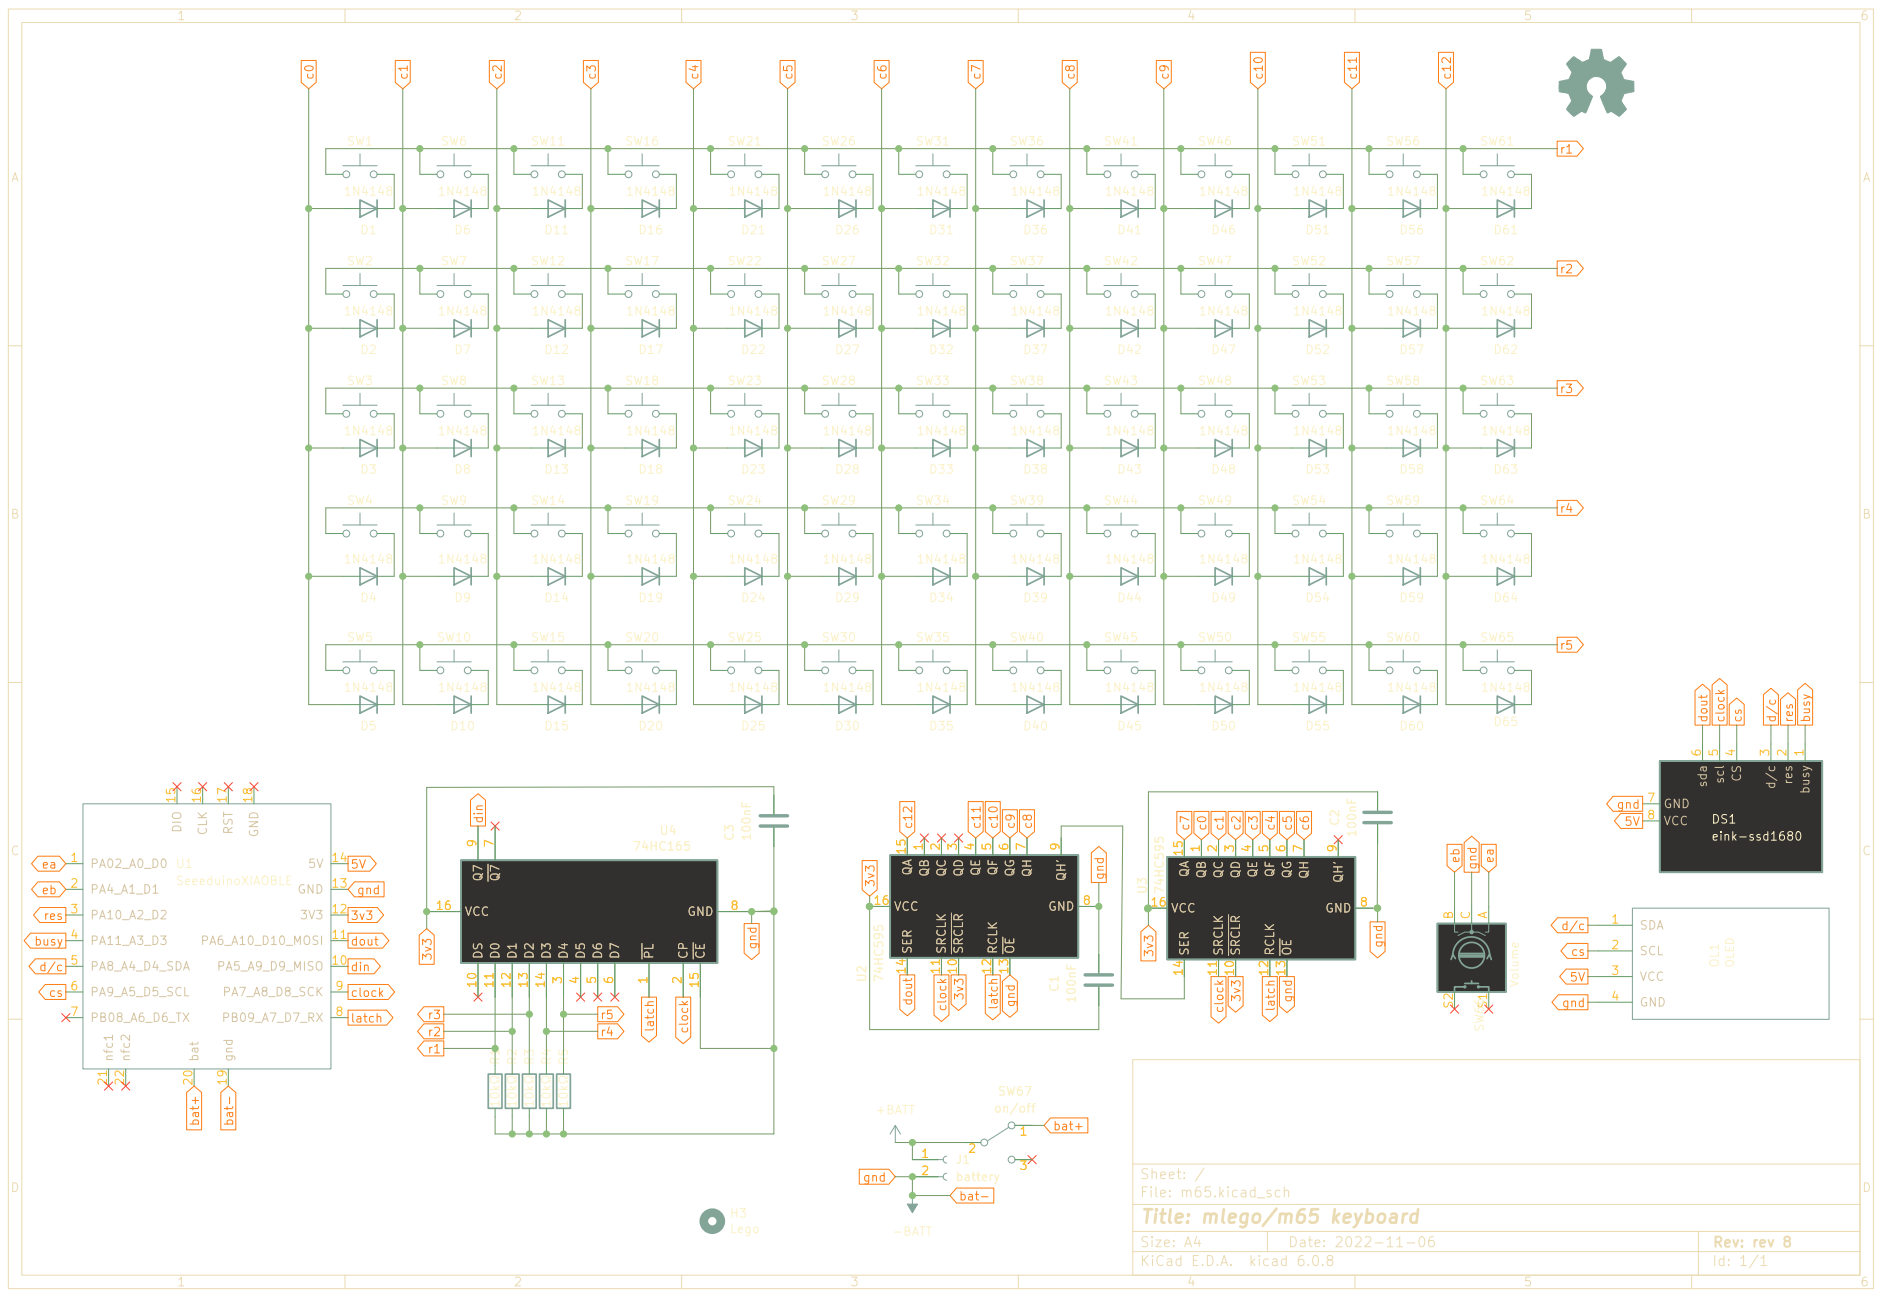
[picture p225: page 1]

A S2S1 SW66 Volume SW49 busy 1 res 2 d/c 3 CS

1 ~{SRCLR} 10 SRCLK 11 RCLK 12 ~{OE} 13 SER 14 QA 15 VCC 16 QC
on/off QB

File: m65.kicad_sch Sheet: /
Id: 1/1 Title: mlego/m65 keyboard
