m-lego/m65/m65.kicad_pcb

## KiCad design m65.kicad_pcb (2024-04-21)

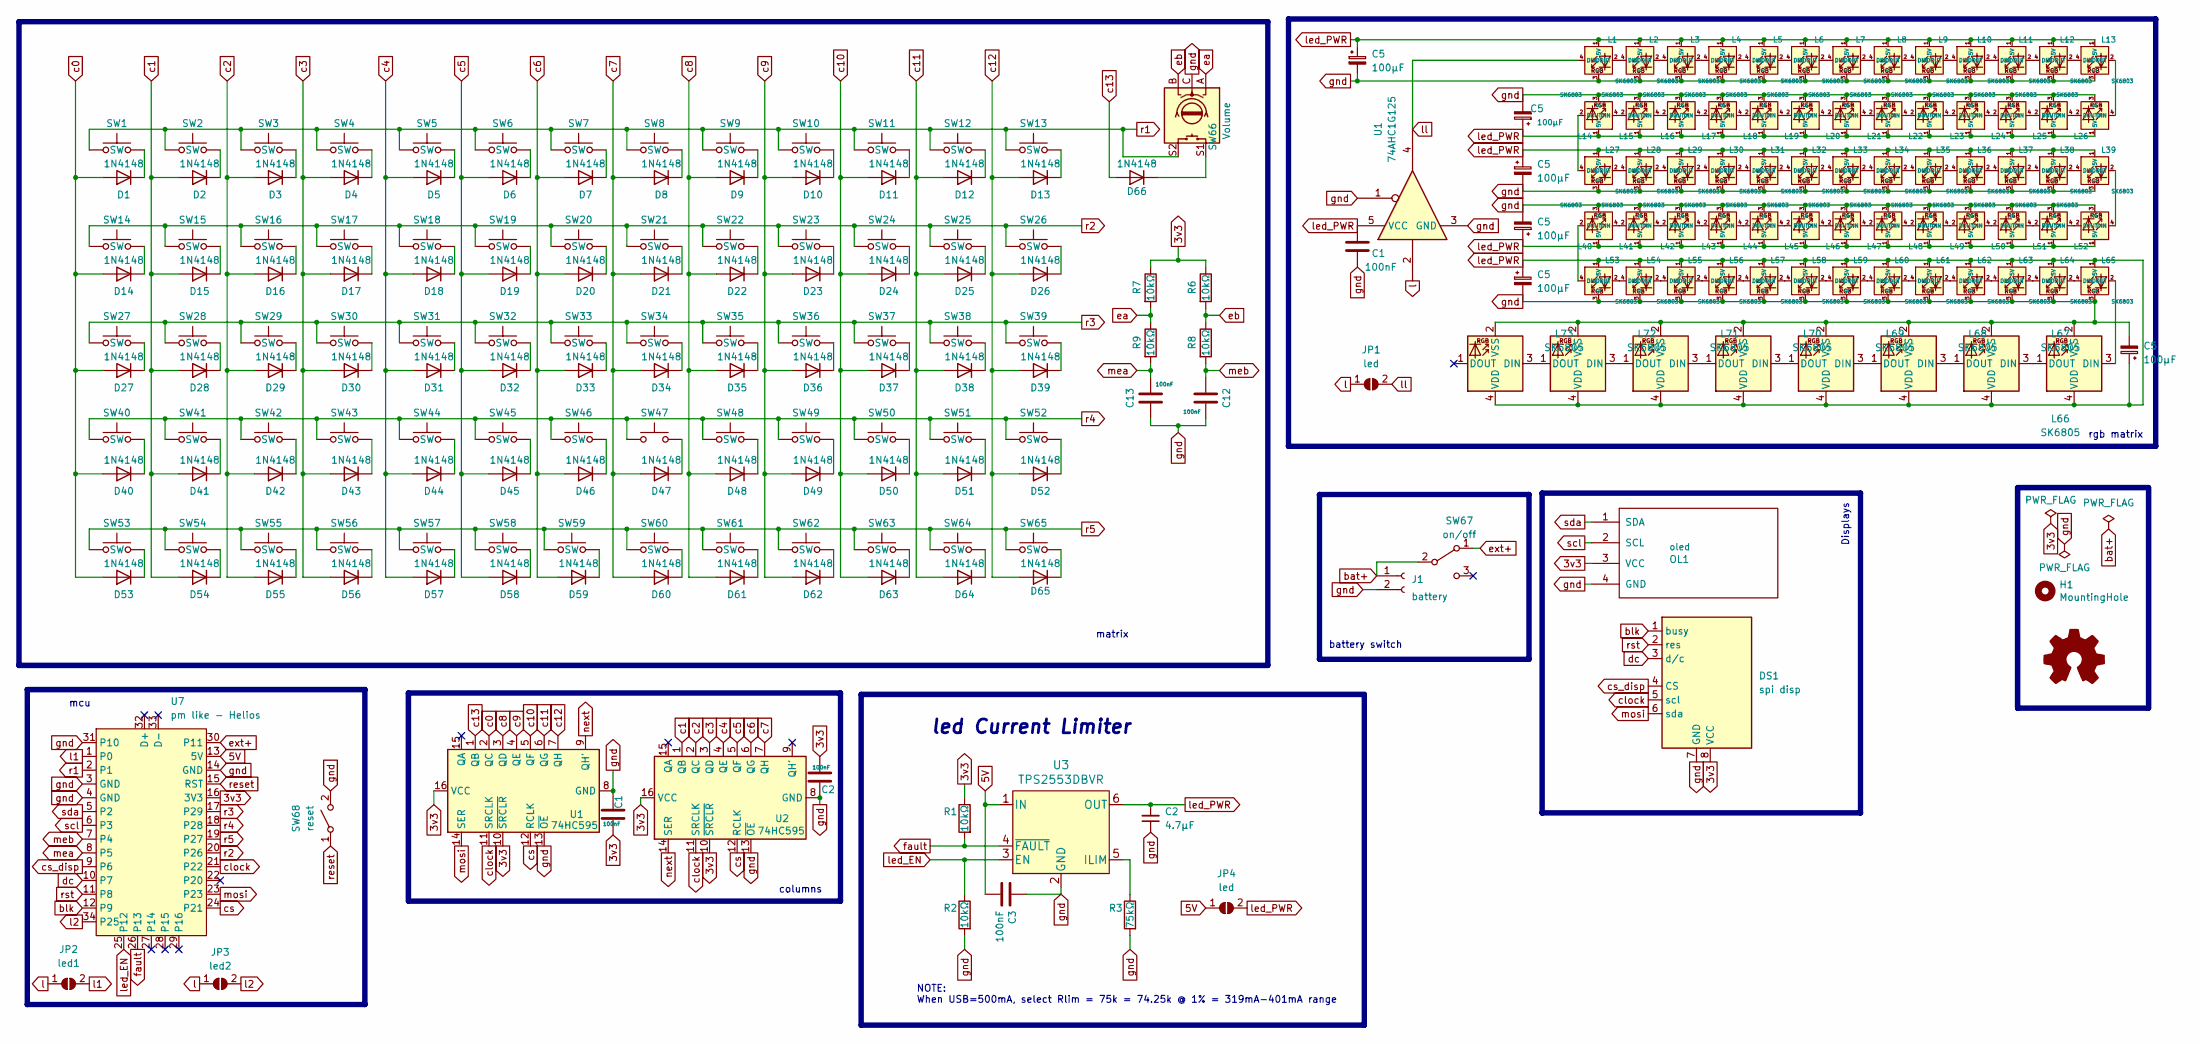
[picture p226: schematic m65.kicad_sch, mlego/m66 keyboard]

Parts:
C1, C2, C3, C12, C13: 100nF; C-1206_3216Metric_Pad1.33x1.80mm_HandSolder-long; LCSC C24497
C5: 100µF; tantalum-3528; LCSC C16133
D1, D2, D3, D4, D5, D6, D7, D8, D9, D10, D11, D12, D13, D14, D15, D16, D17, D18, D19, D20, D21, D22, D23, D24, D25, D26, D27, D28, D29, D30, D31, D32, D33, D34, D35, D36, D37, D38, D39, D40, D41, D42, D43, D44, D45, D46, D47, D48, D49, D50, D51, D52, D53, D54, D55, D56, D57, D58, D59, D60, D61, D62, D63, D64, D65, D66: 1N4148; D_DO-35-SOD-123; LCSC C81598
DS1: spi disp; spi-eink-rgb-sharp
H1: MountingHole; LegoHole_16-32u_4875-rev12
J1: battery; battery connector - no surface
JP1, JP4: led; SolderJumper-Open
JP2: led1; SolderJumper-Open
JP3: led2; SolderJumper-Open
L1, L2, L3, L4, L5, L6, L7, L8, L9, L10, L11, L12, L13, L14, L15, L16, L17, L18, L19, L20, L21, L22, L23, L24, L25, L26, L27, L28, L29, L30, L31, L32, L33, L34, L35, L36, L37, L38, L39, L40, L41, L42, L43, L44, L45, L46, L47, L48, L49, L50, L51, L52, L53, L54, L55, L56, L57, L58, L59, L60, L61, L62, L63, L64, L65: SK6803; SK6812-MINI-E-pins; LCSC C5149201
L66, L67, L68, L69, L70, L71, L72, L73: SK6805; SK6805_PLCC4_2.4x2.7mm_P1.3mm
OL1: oled; OLED_128x32
R1, R2, R6, R7, R8, R9: 10kΩ; R-dual-10k; LCSC C17902
R3: 75kΩ; R-dual-75k; LCSC C17819
SW1: esc; SW_Cherry_MX_1.00u_PCB
SW2: 1; SW_Cherry_MX_1.00u_PCB
SW3: 2; SW_Cherry_MX_1.00u_PCB
SW4: 3; SW_Cherry_MX_1.00u_PCB
SW5: 4; SW_Cherry_MX_1.00u_PCB
SW6: 5; SW_Cherry_MX_1.00u_PCB
SW7: 6; SW_Cherry_MX_1.00u_PCB
SW8: 7; SW_Cherry_MX_1.00u_PCB
SW9: 8; SW_Cherry_MX_1.00u_PCB
SW10: 9; SW_Cherry_MX_1.00u_PCB
SW11: 0; SW_Cherry_MX_1.00u_PCB
SW12: -; SW_Cherry_MX_1.00u_PCB-3d
SW13: back; SW_Cherry_MX_1.00u_PCB-3d
SW14: tab; SW_Cherry_MX_1.00u_PCB
SW15: q; SW_Cherry_MX_1.00u_PCB
SW16: w; SW_Cherry_MX_1.00u_PCB
SW17: e; SW_Cherry_MX_1.00u_PCB
SW18: r; SW_Cherry_MX_1.00u_PCB
SW19: t; SW_Cherry_MX_1.00u_PCB
SW20: y; SW_Cherry_MX_1.00u_PCB
SW21: u; SW_Cherry_MX_1.00u_PCB
SW22: i; SW_Cherry_MX_1.00u_PCB
SW23: o; SW_Cherry_MX_1.00u_PCB
SW24: p; SW_Cherry_MX_1.00u_PCB
SW25: [; SW_Cherry_MX_1.00u_PCB-3d
SW26: ]; SW_Cherry_MX_1.00u_PCB-3d
SW27: #; SW_Cherry_MX_1.00u_PCB
SW28: a; SW_Cherry_MX_1.00u_PCB
SW29: s; SW_Cherry_MX_1.00u_PCB
SW30: d; SW_Cherry_MX_1.00u_PCB
SW31: f; SW_Cherry_MX_1.00u_PCB
SW32: g; SW_Cherry_MX_1.00u_PCB
SW33: h; SW_Cherry_MX_1.00u_PCB
SW34: j; SW_Cherry_MX_1.00u_PCB
SW35: k; SW_Cherry_MX_1.00u_PCB
SW36: l; SW_Cherry_MX_1.00u_PCB
SW37: ;; SW_Cherry_MX_1.00u_PCB
SW38: '; SW_Cherry_MX_1.00u_PCB-3d
SW39: enter; SW_Cherry_MX_1.00u_PCB-3d
SW40, SW62: shift; SW_Cherry_MX_1.00u_PCB
SW41: \; SW_Cherry_MX_1.00u_PCB
SW42: z; SW_Cherry_MX_1.00u_PCB
SW43: x; SW_Cherry_MX_1.00u_PCB
SW44: c; SW_Cherry_MX_1.00u_PCB
SW45: v; SW_Cherry_MX_1.00u_PCB
SW46: b; SW_Cherry_MX_1.00u_PCB
SW47: n; SW_Cherry_MX_1.00u_PCB
SW48: m; SW_Cherry_MX_1.00u_PCB
SW49: ,; SW_Cherry_MX_1.00u_PCB
SW50: .; SW_Cherry_MX_1.00u_PCB
SW51: up; SW_Cherry_MX_1.00u_PCB-3d
SW52: /; SW_Cherry_MX_1.00u_PCB-3d
SW53: ctrl; SW_Cherry_MX_1.00u_PCB
SW54: menu; SW_Cherry_MX_1.00u_PCB
SW55: lower; SW_Cherry_MX_1.00u_PCB
SW56: alt; SW_Cherry_MX_1.00u_PCB
SW57: raise; SW_Cherry_MX_1.00u_PCB
SW58, SW59, SW60: space; SW_Cherry_MX_1.00u_PCB
SW61: altgr; SW_Cherry_MX_1.00u_PCB
SW63: left; SW_Cherry_MX_1.00u_PCB-3d
SW64: down; SW_Cherry_MX_1.00u_PCB-3d
SW65: right; SW_Cherry_MX_1.00u_PCB-3d
SW66: Volume; RotaryEncoder_Alps_EC11E_Vertical_H20mm; LCSC C370970
SW67: on/off; switch_slide
SW68: reset; SW_reset
U1: 74AHC1G125; 74AHC1G125-sot23-v2; LCSC C7468
U2: 74HC595; 74HC595-sop16; LCSC C5947
U3: TPS2553DBVR; SOT-23-6-reg; LCSC C55266
U7: pm like - Helios; Helios_tht

Connections:
5V: C3.2, JP4.1 (A), U3.1 (IN), U7.13 (5V)
unnamed: D1.1 (K), SW1.2
unnamed: D2.1 (K), SW2.2
unnamed: D3.1 (K), SW3.2
unnamed: D4.1 (K), SW4.2
unnamed: D5.1 (K), SW5.2
unnamed: D6.1 (K), SW6.2
unnamed: D7.1 (K), SW7.2
unnamed: D8.1 (K), SW8.2
unnamed: D9.1 (K), SW9.2
unnamed: D10.1 (K), SW10.2
unnamed: D11.1 (K), SW11.2
unnamed: D12.1 (K), SW12.2
unnamed: D13.1 (K), SW13.2
unnamed: D14.1 (K), SW14.2
unnamed: D15.1 (K), SW15.2
unnamed: D16.1 (K), SW16.2
unnamed: D17.1 (K), SW17.2
unnamed: D18.1 (K), SW18.2
unnamed: D19.1 (K), SW19.2
unnamed: D20.1 (K), SW20.2
unnamed: D21.1 (K), SW21.2
unnamed: D22.1 (K), SW22.2
unnamed: D23.1 (K), SW23.2
unnamed: D24.1 (K), SW24.2
unnamed: D25.1 (K), SW25.2
unnamed: D26.1 (K), SW26.2
unnamed: D27.1 (K), SW27.2
unnamed: D28.1 (K), SW28.2
unnamed: D29.1 (K), SW29.2
unnamed: D30.1 (K), SW30.2
unnamed: D31.1 (K), SW31.2
unnamed: D32.1 (K), SW32.2
unnamed: D33.1 (K), SW33.2
unnamed: D34.1 (K), SW34.2
unnamed: D35.1 (K), SW35.2
unnamed: D36.1 (K), SW36.2
unnamed: D37.1 (K), SW37.2
unnamed: D38.1 (K), SW38.2
unnamed: D39.1 (K), SW39.2
unnamed: D40.1 (K), SW40.2
unnamed: D41.1 (K), SW41.2
unnamed: D42.1 (K), SW42.2
unnamed: D43.1 (K), SW43.2
unnamed: D44.1 (K), SW44.2
unnamed: D45.1 (K), SW45.2
unnamed: D46.1 (K), SW46.2
unnamed: D47.1 (K), SW47.2
unnamed: D48.1 (K), SW48.2
unnamed: D49.1 (K), SW49.2
unnamed: D50.1 (K), SW50.2
unnamed: D51.1 (K), SW51.2
unnamed: D52.1 (K), SW52.2
unnamed: D53.1 (K), SW53.2
unnamed: D54.1 (K), SW54.2
unnamed: D55.1 (K), SW55.2
unnamed: D56.1 (K), SW56.2
unnamed: D57.1 (K), SW57.2
unnamed: D58.1 (K), SW58.2
unnamed: D59.1 (K), SW59.2
unnamed: D60.1 (K), SW60.2
unnamed: D61.1 (K), SW61.2
unnamed: D62.1 (K), SW62.2
unnamed: D63.1 (K), SW63.2
unnamed: D64.1 (K), SW64.2
unnamed: D65.1 (K), SW65.2
unnamed: D66.1 (K), SW66.S1
unnamed: L1.2 (DOUT), L2.4 (DIN)
unnamed: L2.2 (DOUT), L3.4 (DIN)
unnamed: L3.2 (DOUT), L4.4 (DIN)
unnamed: L4.2 (DOUT), L5.4 (DIN)
unnamed: L5.2 (DOUT), L6.4 (DIN)
unnamed: L6.2 (DOUT), L7.4 (DIN)
unnamed: L7.2 (DOUT), L8.4 (DIN)
unnamed: L8.2 (DOUT), L9.4 (DIN)
unnamed: L9.2 (DOUT), L10.4 (DIN)
unnamed: L10.2 (DOUT), L11.4 (DIN)
unnamed: L11.2 (DOUT), L12.4 (DIN)
unnamed: L12.2 (DOUT), L13.4 (DIN)
unnamed: L13.2 (DOUT), L26.4 (DIN)
unnamed: L14.4 (DIN), L15.2 (DOUT)
unnamed: L14.2 (DOUT), L27.4 (DIN)
unnamed: L15.4 (DIN), L16.2 (DOUT)
unnamed: L16.4 (DIN), L17.2 (DOUT)
unnamed: L17.4 (DIN), L18.2 (DOUT)
unnamed: L18.4 (DIN), L19.2 (DOUT)
unnamed: L19.4 (DIN), L20.2 (DOUT)
unnamed: L20.4 (DIN), L21.2 (DOUT)
unnamed: L21.4 (DIN), L22.2 (DOUT)
unnamed: L22.4 (DIN), L23.2 (DOUT)
unnamed: L23.4 (DIN), L24.2 (DOUT)
unnamed: L24.4 (DIN), L25.2 (DOUT)
unnamed: L25.4 (DIN), L26.2 (DOUT)
unnamed: L27.2 (DOUT), L28.4 (DIN)
unnamed: L28.2 (DOUT), L29.4 (DIN)
unnamed: L29.2 (DOUT), L30.4 (DIN)
unnamed: L30.2 (DOUT), L31.4 (DIN)
unnamed: L31.2 (DOUT), L32.4 (DIN)
unnamed: L32.2 (DOUT), L33.4 (DIN)
unnamed: L33.2 (DOUT), L34.4 (DIN)
unnamed: L34.2 (DOUT), L35.4 (DIN)
unnamed: L35.2 (DOUT), L36.4 (DIN)
unnamed: L36.2 (DOUT), L37.4 (DIN)
unnamed: L37.2 (DOUT), L38.4 (DIN)
unnamed: L38.2 (DOUT), L39.4 (DIN)
unnamed: L39.2 (DOUT), L52.4 (DIN)
unnamed: L40.4 (DIN), L41.2 (DOUT)
unnamed: L40.2 (DOUT), L53.4 (DIN)
unnamed: L41.4 (DIN), L42.2 (DOUT)
unnamed: L42.4 (DIN), L43.2 (DOUT)
unnamed: L43.4 (DIN), L44.2 (DOUT)
unnamed: L44.4 (DIN), L45.2 (DOUT)
unnamed: L45.4 (DIN), L46.2 (DOUT)
unnamed: L46.4 (DIN), L47.2 (DOUT)
unnamed: L47.4 (DIN), L48.2 (DOUT)
unnamed: L48.4 (DIN), L49.2 (DOUT)
unnamed: L49.4 (DIN), L50.2 (DOUT)
unnamed: L50.4 (DIN), L51.2 (DOUT)
unnamed: L51.4 (DIN), L52.2 (DOUT)
unnamed: L53.2 (DOUT), L54.4 (DIN)
unnamed: L54.2 (DOUT), L55.4 (DIN)
unnamed: L55.2 (DOUT), L56.4 (DIN)
unnamed: L56.2 (DOUT), L57.4 (DIN)
unnamed: L57.2 (DOUT), L58.4 (DIN)
unnamed: L58.2 (DOUT), L59.4 (DIN)
unnamed: L59.2 (DOUT), L60.4 (DIN)
unnamed: L60.2 (DOUT), L61.4 (DIN)
unnamed: L61.2 (DOUT), L62.4 (DIN)
unnamed: L62.2 (DOUT), L63.4 (DIN)
unnamed: L63.2 (DOUT), L64.4 (DIN)
unnamed: L64.2 (DOUT), L65.4 (DIN)
unnamed: L65.2 (DOUT), L66.3 (DIN)
unnamed: L66.1 (DOUT), L67.3 (DIN)
unnamed: L67.1 (DOUT), L68.3 (DIN)
unnamed: L68.1 (DOUT), L69.3 (DIN)
unnamed: L69.1 (DOUT), L70.3 (DIN)
unnamed: L70.1 (DOUT), L71.3 (DIN)
unnamed: L71.1 (DOUT), L72.3 (DIN)
unnamed: L72.1 (DOUT), L73.3 (DIN)
unnamed: R3.1, U3.5 (ILIM)
bat+: J1.1, SW67.2 (B)
blk: DS1.1 (busy), U7.12 (P9)
c1: D2.2 (A), D15.2 (A), D28.2 (A), D41.2 (A), D54.2 (A), U2.1 (QB)
c2: D3.2 (A), D16.2 (A), D29.2 (A), D42.2 (A), D55.2 (A), U2.2 (QC)
c3: D4.2 (A), D17.2 (A), D30.2 (A), D43.2 (A), D56.2 (A), U2.3 (QD)
c4: D5.2 (A), D18.2 (A), D31.2 (A), D44.2 (A), D57.2 (A), U2.4 (QE)
c5: D6.2 (A), D19.2 (A), D32.2 (A), D45.2 (A), D58.2 (A), U2.5 (QF)
c6: D7.2 (A), D20.2 (A), D33.2 (A), D46.2 (A), D59.2 (A), U2.6 (QG)
c7: D8.2 (A), D21.2 (A), D34.2 (A), D47.2 (A), D60.2 (A), U2.7 (QH)
c11: D12.2 (A), D25.2 (A), D38.2 (A), D51.2 (A), D64.2 (A), U1.6 (QG)
c12: D13.2 (A), D26.2 (A), D39.2 (A), D52.2 (A), D65.2 (A), U1.7 (QH)
clock: DS1.5 (scl), U1.11 (SRCLK), U2.11 (SRCLK), U7.21 (P22)
cs: U1.12 (RCLK), U2.12 (RCLK), U7.24 (P21)
cs_disp: DS1.4 (CS), U7.9 (P6)
dc: DS1.3 (d/c), U7.10 (P7)
ea: R7.2, R9.1, SW66.A
eb: R6.2, R8.1, SW66.B
ext+: SW67.1 (A), U7.30 (P11)
fault: R1.2, U3.4 (~FAULT), U7.26 (P13)
l1: JP2.2 (B), U7.1 (P0)
l2: JP3.2 (B), U7.34 (P25)
led_EN: R2.1, U3.3 (EN), U7.25 (P12)
mea: C13.2, R9.2, U7.8 (P5)
meb: C12.2, R8.2, U7.7 (P4)
mosi: DS1.6 (sda), U1.14 (SER), U7.23
next: U1.9 (QH'), U2.14 (SER)
r1: SW1.1, SW2.1, SW3.1, SW4.1, SW5.1, SW6.1, SW7.1, SW8.1, SW9.1, SW10.1, SW11.1, SW12.1, SW13.1, SW66.S2, U7.2 (P1)
r2: SW14.1, SW15.1, SW16.1, SW17.1, SW18.1, SW19.1, SW20.1, SW21.1, SW22.1, SW23.1, SW24.1, SW25.1, SW26.1, U7.20 (P26)
r3: SW27.1, SW28.1, SW29.1, SW30.1, SW31.1, SW32.1, SW33.1, SW34.1, SW35.1, SW36.1, SW37.1, SW38.1, SW39.1, U7.17 (P29)
r4: SW40.1, SW41.1, SW42.1, SW43.1, SW44.1, SW45.1, SW46.1, SW47.1, SW48.1, SW49.1, SW50.1, SW51.1, SW52.1, U7.18 (P28)
r5: SW53.1, SW54.1, SW55.1, SW56.1, SW57.1, SW58.1, SW59.1, SW60.1, SW61.1, SW62.1, SW63.1, SW64.1, SW65.1, U7.19 (P27)
reset: SW68.1 (A), U7.15 (RST)
rst: DS1.2 (res), U7.11 (P8)
scl: OL1.2 (SCL), U7.6 (P3)
sda: OL1.1 (SDA), U7.5 (P2)

Notes on the sheet:
columns
led Current Limiter
mcu
Displays
battery switch
NOTE: When USB=500mA, select Rlim = 75k = 74.25k @ 1% = 319mA-401mA range
rgb matrix
matrix

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
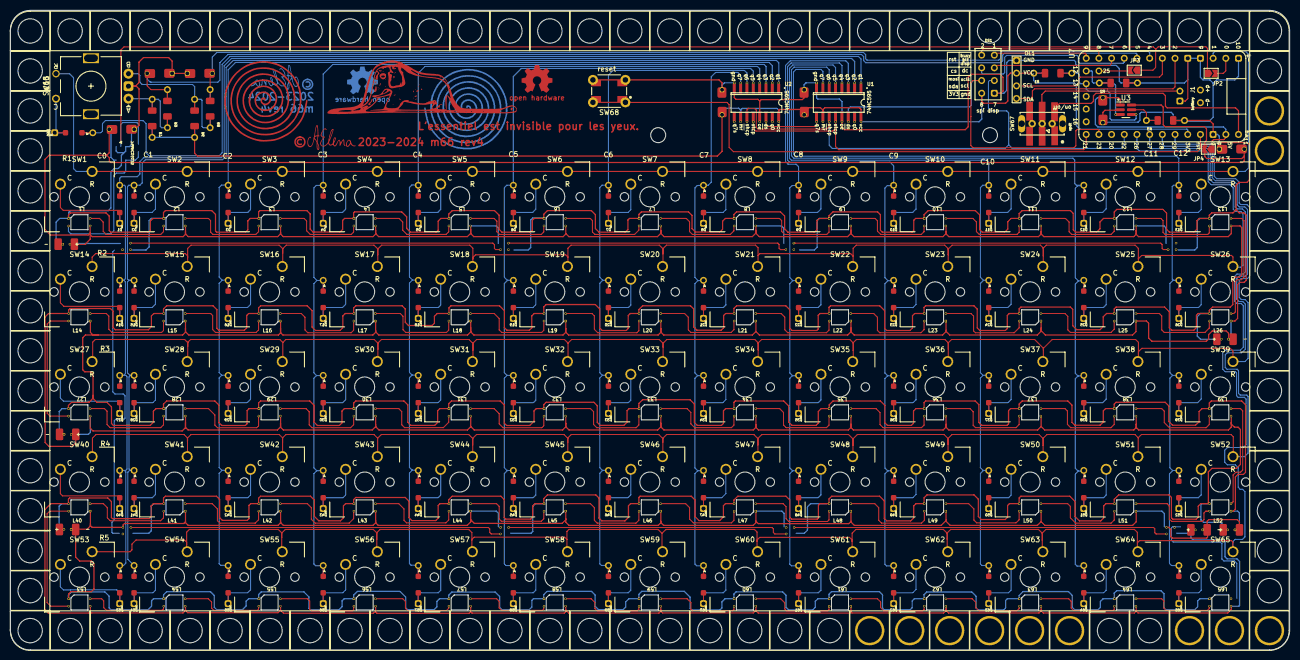
[picture p227: board m65.kicad_pcb from above]

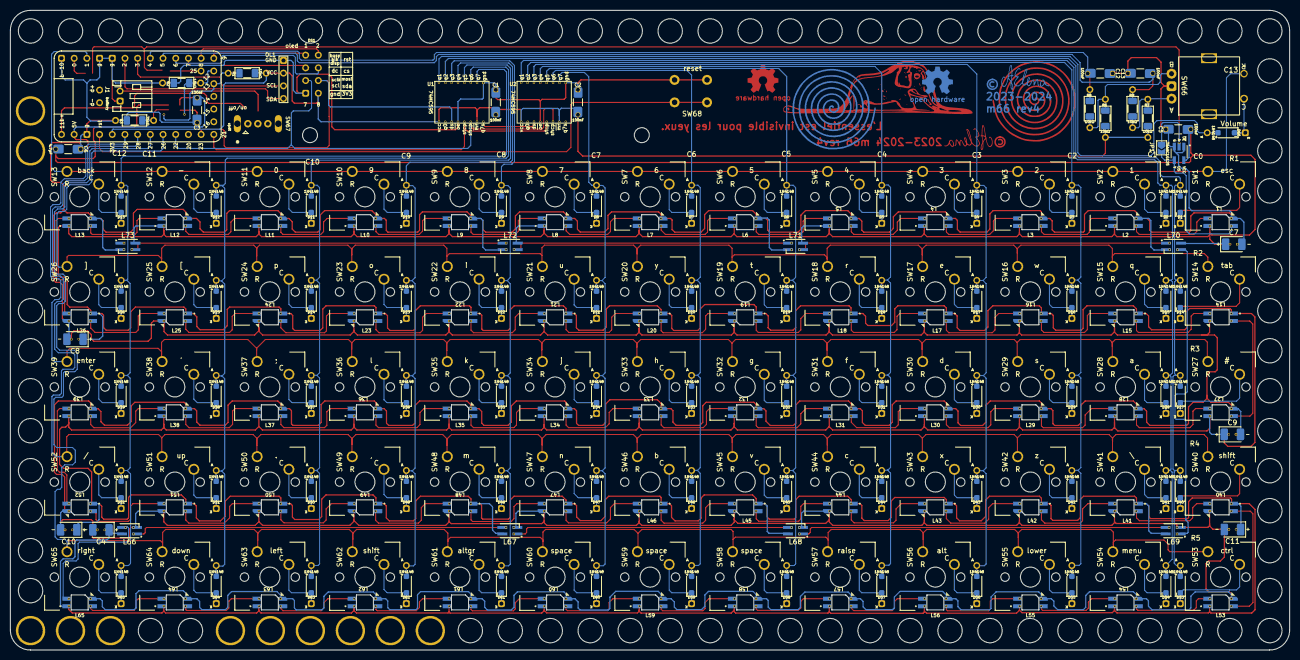
[picture p228: board m65.kicad_pcb from below]

Board: 2 copper layers, 256.0 x 128.0 mm, 245 parts (163 on the bottom side), 185 nets.

Other parts of the board:
C4, C7, C8, C9, C10, C11: 100µF; tantalum-3528
C6: 4.7µF; C-1206_3216Metric_Pad1.33x1.80mm_HandSolder-long
G1, G3: LOGO; sig-copper
G4: LOGO; el-copper
G5, G5#2: OSHW; OSHW-Logo2_9.8x8mm_Copper
U5: 74AHC1G125; 74AHC1G125-sot23-v2
