m-lego/m65/(commit log)

2021-02-14 latest changed
    [m65.kicad_pcb]
2021-02-14 add plate pcb just in case
    [53140a16601c2cde6f90537a3c5aa2a0741da489_switch.dxf, platepcb.kicad_pcb, platepcb.sch]
2021-05-03 lego holes 4.85mm now maybe not so tight
    [m65.kicad_pcb, m65.sch]
2021-07-24 4.9mm lego diam
    [m65.kicad_pcb]
2021-08-26 add encoder, and fix lego hole to 4.9 drill too
    [m65.kicad_pcb, m65.sch]
2021-08-27 keep kerbers with right drill size
2021-09-12 add jst headers for leds, and a rotary encoder, also add support for f401, drill holes are now 4.9mm
    [m65.kicad_pcb, m65.sch]
2021-09-12 add m48 pcb
2021-09-12 [m65] more pcbs
2021-10-04 add stm32f401 gerbers
2021-10-05 current version
2021-12-17 remove plate
    [53140a16601c2cde6f90537a3c5aa2a0741da489_switch.dxf, platepcb.kicad_pcb, platepcb.sch]
2022-01-08 version 5 up
    [m65.kicad_pcb, m65.kicad_sch, m65.sch]
2022-01-29 add rev4 gerbers
    [m65.kicad_pcb, m65.kicad_sch]
2022-01-31 start assembly guide
2022-01-31 assembly guide
2022-02-12 add gerbers
    [m65.kicad_pcb, m65.kicad_sch]
2022-05-21 add color code for resistors
    [m65.kicad_pcb, m65.kicad_sch]
2022-09-03 update info
    [m65.kicad_pcb, m65.kicad_sch]
2022-12-20 add kicad for revision 9
    [m65-rounded.kicad_pcb, m65.kicad_sch]
2022-12-28 complete rev9
    [m65-rounded.kicad_pcb, m65.kicad_pcb, m65.kicad_sch]
2023-01-02 update to rev9
    [m65-rounded.kicad_pcb, m65.kicad_pcb, m65.kicad_sch]
2023-01-06 update rev9
    [m65-rounded.kicad_pcb, m65.kicad_pcb, m65.kicad_sch]
2023-01-28 update to rev10, surface mount but still intermediate
2023-02-07 update pcb to rev10 untested
    [m65-rounded.kicad_pcb, m65.kicad_pcb, m65.kicad_sch]
2023-04-02 expands notes
    [m65-rounded.kicad_pcb, m65.kicad_pcb]
2023-04-02 add example on matrix
    [m65-rounded.kicad_pcb]
2023-05-09 correct ble footprint
2023-05-19 update to almost rev11
    [m65-rounded.kicad_pcb, m65.kicad_pcb, m65.kicad_sch]
2023-05-29 section the pcbs
2023-05-29 add schematic
2023-05-29 add schematics
2023-05-29 gerbers are nice in one place now
2023-05-29 add rev10 pcb
2023-05-29 add pcb infos
2023-05-30 add rev9 gerbers
2023-05-30 remove rev10 gerbers
2023-06-02 activate leds
2023-06-02 rev11 gerbers
2023-06-02 update rev9 and add gerbers
2023-06-18 start toy revision 12
    [m65.kicad_pcb, m65.kicad_sch]
2023-06-18 rev12 alpha untested
    [m65-rounded.kicad_pcb, m65.kicad_pcb, m65.kicad_sch]
2023-06-18 add footprints
    [m65-rounded.kicad_pcb, m65.kicad_pcb, m65.kicad_sch]
2023-08-08 update add splinky
    [m65.kicad_pcb, m65.kicad_sch]
2023-08-28 update rev12 almost ready
    [m65-rounded.kicad_pcb, m65.kicad_pcb, m65.kicad_sch]
2023-08-29 update silkscreen
    [m65-rounded.kicad_pcb, m65.kicad_pcb, m65.kicad_sch]
2023-08-29 update add filter for encoder
    [m65-rounded.kicad_pcb, m65.kicad_pcb, m65.kicad_sch]
2024-01-22 update gerbers
    [m65-rounded.kicad_pcb, m65.kicad_pcb]
2024-02-17 m66 rev4
    [m65-rev4-bom.csv]
2024-04-01 fix spelling mistake and slightly improve the routing and positioning
    [m65-rounded.kicad_pcb, m65.kicad_pcb, m65.kicad_sch]
