m-lego/m65/(notices)

Notices in the files:
m65.kicad_pcb:
© 2023-2024 m66 rev4
